PSMangelsdorf/Bolt_Invt/V0.1/ReadMe

First Pass at replacement logic board via Claude
