PSMangelsdorf/Bolt_Invt/V0.1/fab/README.md

# Bolt logic board v0.1: prototype fabrication files

**Prototype for bench testing. Do not install in a vehicle.** See *Open items* below.

Generated by `hardware/bolt_logic/tools/gen_fab.py` from `bolt_logic.kicad_pcb`; don't edit by hand.

| File | What it is |
|----|----|
| `bolt_logic_v0.1_gerbers.zip` | Gerbers (F.Cu, In1.Cu, In2.Cu, B.Cu, masks, paste, silk, outline) and Excellon drill files (plated and non-plated separate). Upload this as the PCB. |
| `bolt_logic_v0.1_bom_jlc.csv` | JLCPCB assembly BOM (61 lines), LCSC part numbers. |
| `bolt_logic_v0.1_cpl_jlc.csv` | JLCPCB placement file (220 parts, side: Top). |
| `bolt_logic_v0.1_bom_full.csv` | Every part: chosen spec, MPN, where the LCSC number was checked, and who fits it. |

## PCB order settings

| Setting | Value |
|----|----|
| Layers | 4 |
| Size | 289.1 x 112.1 mm (outline in the Gerbers) |
| Thickness | 2.0 mm |
| Material | FR-4 |
| Outer copper | **2 oz** (not the default; owner decision, for the 5 V buck's heat) |
| Inner copper | 1 oz |
| Stackup | the fab's standard 4-layer 2.0 mm stackup for this copper weight; no impedance control needed |
| Min track / gap | 0.20 mm / 0.20 mm (every copper gap passes DRC at 0.20 mm) |
| Min hole | 0.30 mm; vias 0.6 / 0.3 mm pad / drill |
| Surface finish | your choice. ENIG is flatter for the 0.5 mm pitch MCU; HASL is cheaper. |
| Remove order number | optional: there is no reserved spot for it on the silkscreen |

JLCPCB's 4-layer 2 oz limits (0.15 / 0.15 mm track and gap, 0.254 mm annular ring on
component holes) are met. A fab that needs 10 / 10 mil at 2 oz would not accept this
board; see `docs/04-layout.md` §1.

## Assembly

- Assemble the **top side** only, from the BOM and CPL above.
- Positions and rotations are KiCad's footprint origins and orientations, in the same
  frame as the Gerbers. JLCPCB's preview sometimes shows a part rotated by 90° or 180°
  against its library model (SOT-23, SOIC and LQFP most often), or offset where the
  footprint origin isn't the body centre (TO-252, TO-263, the ESP32 module). Check every
  IC's pin-1 marker and those bodies in the placement preview before confirming, or ask
  their DFM review to.
- Check stock for each line when you upload; JLCPCB shows it, and these numbers were
  checked in October 2026.

Fit by hand after delivery (or order through JLCPCB Global Sourcing, where noted):

| Ref | Part | Note |
|----|----|----|
| CN1 | GM 48-way header (part not yet identified) | hand-solder (owner); 1.0 mm placeholder holes |
| CN2 | SSW-120-01-T-D-LL (Samtec) | hand-solder (owner) |
| J1 | 1x05 2.54 mm header | hand-solder |
| J4 | 1x06 2.54 mm header | hand-solder |

## Open items before trusting this board

1. **TCA0372 pinout (U13, resolver exciter).** The symbol uses VCC = 1, OUTB = 2,
   GND = 4 / 5 / 12 / 13, -INB = 7, +INB = 8, +INA = 9, -INA = 10, OUTA = 16, NC = 3 / 6 / 11
   / 14 / 15. Two sources agree on this: the label order of the datasheet's DW pin drawing,
   and a component-library pin table. The drawing itself is a figure, so glance at it in
   onsemi's datasheet before ordering.
2. **BTS133TC (U20-U22).** C2681318 comes from the V6 BOM and isn't found at LCSC. If
   JLCPCB can't place it, fit it by hand.
3. **L30, the ESP32 supply inductor.** It is a 10 uH 0805, as on V6 (which used a 0603).
   No 0805 10 uH part is really rated for the ESP32's ~0.5 A transmit peaks. Watch for WiFi
   brown-outs on the bench.
4. **CN1 holes** are 1.0 mm placeholders; the GM header part isn't identified yet.
5. **CN2 pin 18** is assumed to be the DC-bus voltage (bench test before high voltage).
