PSMangelsdorf/Bolt_Invt/V0.1/docs/layout_placement.png

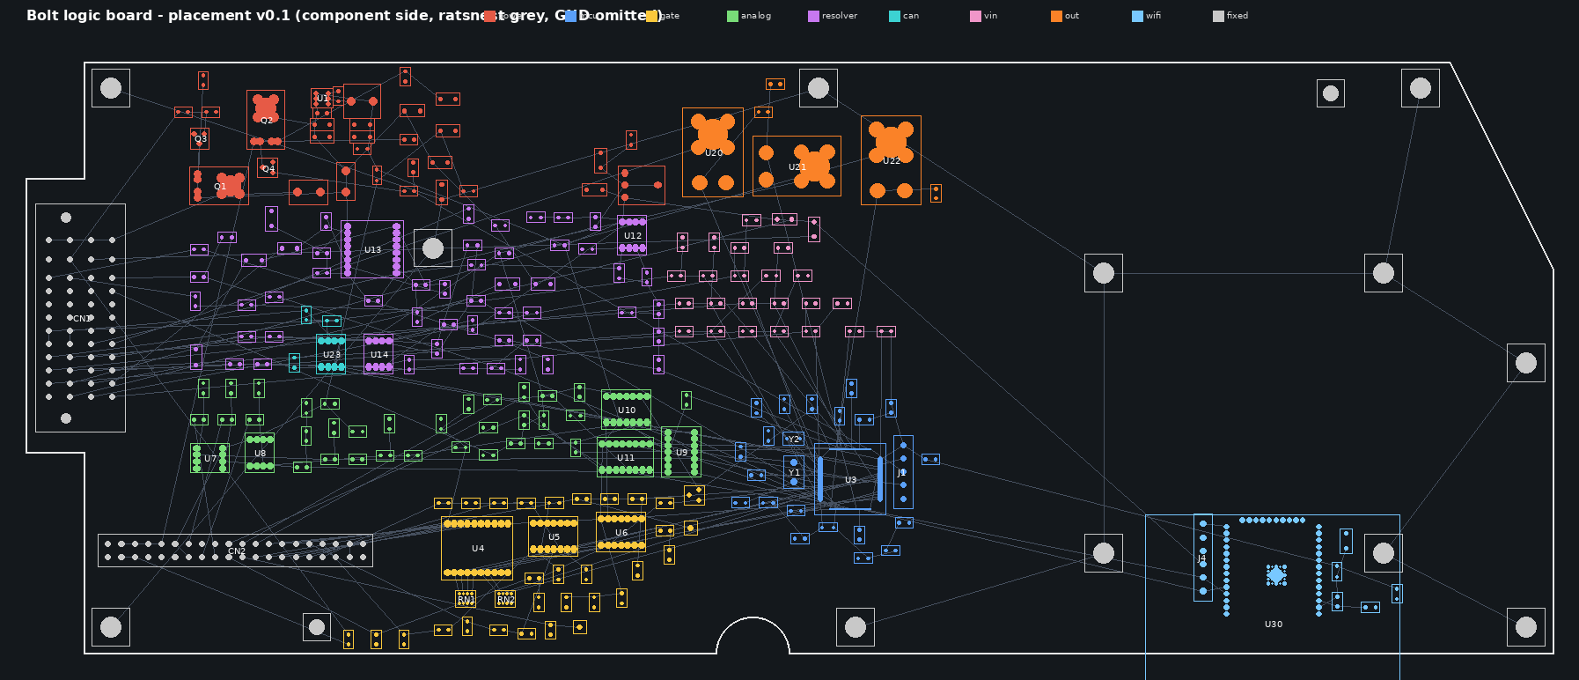
V0.1/docs/layout_placement.png
