PSMangelsdorf/Bolt_Invt/V0.1/docs/layout_routed.png

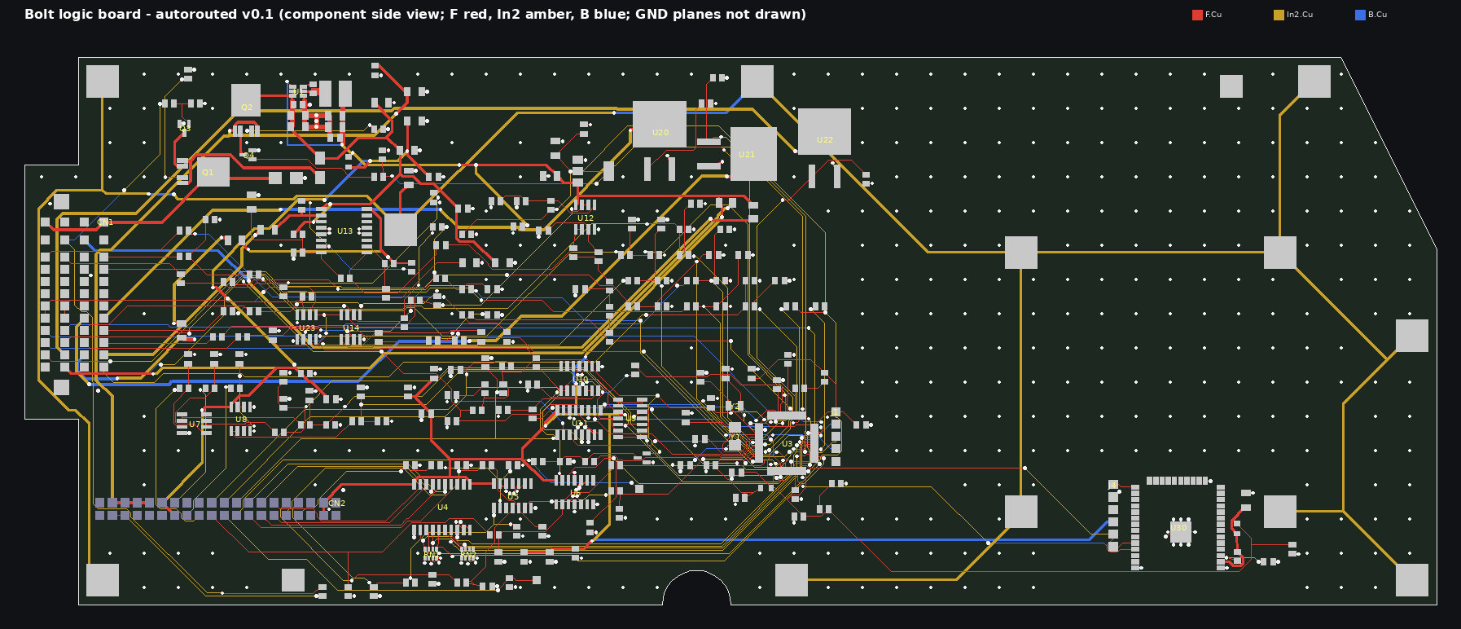
V0.1/docs/layout_routed.png
