PSMangelsdorf/Bolt_Invt/V0.1/docs/mechanical_overlay.png

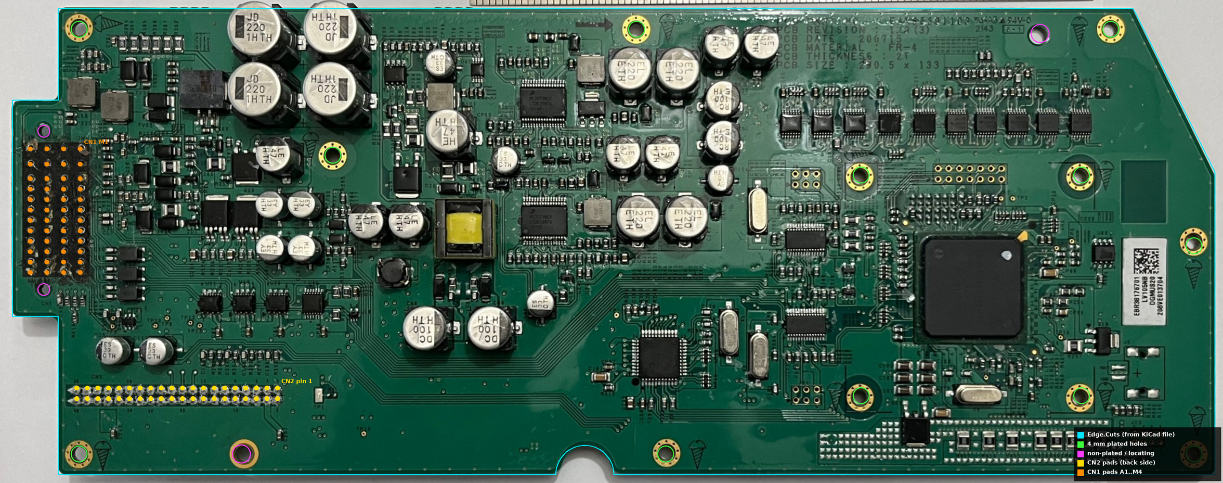
V0.1/docs/mechanical_overlay.png
