PSMangelsdorf/Bolt_Invt/V0.1/fab/bolt_logic_v0.1_bom_full.csv

Qty | Designators | Value | Footprint | Chosen spec | MPN | LCSC | Source | Fit by | Note
4 | C1,C2,C3,C4 | 10uF 50V | C_1206_3216Metric | 10 uF X5R 50 V | CL31A106KBHNNNE | C13585 | lcsc | smt
27 | C5,C6,C9,C12,C14,C16,C20,C21,C22,C23,C26,C27,C40,C46,C47,C54,C57,C60,C61,C62,C73,C75,C79,C84,C109,C121,C122 | 100nF | C_0805_2012Metric | 100 nF X7R 50 V | CC0805KRX7R9BB104 | C49678 | lcsc | smt | same part as V6; 50 V because some sit on 12 V rails
3 | C7,C8,C11 | 22uF | C_1206_3216Metric | 22 uF X5R 25 V | CL31A226KAHNNNE | C12891 | lcsc | smt
3 | C10,C13,C120 | 10uF | C_1206_3216Metric | 10 uF X5R 25 V | CL31A106KAHNNNE | C9807 | lcsc | smt | 5 V / 3.3 V rails
5 | C15,C77,C78,C80,C81 | 10uF 25V | C_1206_3216Metric | 10 uF X5R 25 V | CL31A106KAHNNNE | C9807 | lcsc | smt
1 | C24 | 4.7uF | C_0805_2012Metric | 4.7 uF X5R 25 V | CL21A475KAQNNNE | C1779 | lcsc | smt
15 | C25,C58,C59,C63,C64,C65,C66,C76,C100,C101,C102,C103,C104,C107,C108 | 1uF | C_0805_2012Metric | 1 uF X7R 50 V | CL21B105KBFNNNE | C28323 | lcsc | smt | same part as V6
2 | C28,C29 | 22pF | C_0805_2012Metric | 22 pF C0G 50 V | 0805CG220J500NT | C24658 | lcsc | smt
2 | C30,C31 | 10pF | C_0805_2012Metric | 10 pF C0G 50 V | 0805CG100J500NT | C157608 | lcsc | smt
5 | C41,C42,C43,C44,C45 | 10nF | C_0805_2012Metric | 10 nF X7R 50 V | CL21B103KBANNNC | C1710 | lcsc | smt | same part as V6
11 | C48,C51,C53,C56,C82,C83,C85,C86,C87,C88,C89 | 1nF | C_0805_2012Metric | 1 nF X7R 50 V | CL21B102KBCNNNC | C46653 | lcsc | smt | same part as V6
4 | C50,C52,C55,C71 | 4.7nF | C_0805_2012Metric | 4.7 nF C0G 50 V (Murata) | GRM2165C1H472JA01D | C77063 | lcsc | smt | C0G proposed: exciter filter and current-sense filters
1 | C70 | 3.3nF | C_0805_2012Metric | 3.3 nF C0G 50 V (Murata) | GRM2165C1H332JA01D | C77062 | lcsc | smt | C0G proposed: exciter sine filter
1 | C72 | 2.2nF | C_0805_2012Metric | 2.2 nF C0G 50 V | 0805CG222J500NT | C51795 | lcsc | smt | C0G proposed: exciter sine filter
1 | CN1 | GM X1 48-way | CN1_GM_48pos_4x12 | vehicle connector | GM 48-way header (part not yet identified) |  |  | hand | hand-solder (owner); 1.0 mm placeholder holes
1 | CN2 | SSW-120-01-T-D-LL | CN2_2x20_P2.54_Receptacle_Back | 2x20 receptacle, bottom side | SSW-120-01-T-D-LL (Samtec) |  |  | hand | hand-solder (owner)
1 | D1 | SS54 | D_SMA | 40 V 5 A Schottky (MDD) | SS54 | C22452 | lcsc | smt | same part as V6
1 | D2 | BAT54S | SOT-23 | dual Schottky, series (Nexperia) | BAT54S,215 | C47546 | lcsc | smt
1 | F1 | 50mA | Fuse_1206_3216Metric | PPTC 50 mA hold, 60 V (Littelfuse) | 1206L005/60WR | C315892 | lcsc | smt
1 | F2 | 200mA | Fuse_1206_3216Metric | PPTC 200 mA hold, 24 V (Littelfuse) | 1206L020YR | C207035 | lcsc | smt
1 | FB1 | 600R@100MHz 1A | L_0805_2012Metric | 600 ohm @ 100 MHz, 500 mA, 0.3 ohm | GZ2012D601TF | C1017 | lcsc | smt | rated 500 mA, not the 1 A in the value field; the +5V_A load (gate-board current sensors) is well under that
1 | J1 | SWD | PinHeader_1x05_P2.54mm_Vertical | SWD | 1x05 2.54 mm header |  |  | hand | hand-solder
1 | J4 | ESP PROG | PinHeader_1x06_P2.54mm_Vertical | ESP32 programming | 1x06 2.54 mm header |  |  | hand | hand-solder
1 | L1 | 6.8uH | L_Bourns_SRN6045TA | 6.8 uH 20% (Bourns) | SRN6045TA-6R8M | C2041457 | lcsc | smt
2 | L2,L30 | 10uH | L_0805_2012Metric | 10 uH 0805, DCR 0.3 ohm (TDK) | MLZ2012N100LT000 | C88182 | lcsc | smt | L30 feeds the ESP32 (~0.5 A transmit peaks): no 0805 10 uH part is really rated for that. V6 used a 0603 10 uH (C1035) here. Review
1 | LED1 | PWR green | LED_0805_2012Metric | green 0805 | KT-0805G | C2297 | lcsc | smt
1 | LED2 | STATUS | LED_0805_2012Metric | green 0805 | KT-0805G | C2297 | lcsc | smt | colour not specified; green proposed
2 | Q1,Q2 | BTS6143D | TO-252-4 | PROFET high-side 10 mohm, PG-TO252-5-11 (Infineon) | BTS6143D | C95232 | lcsc | smt | owner: replaces BTS443P (same pinout and IN-to-GND input)
2 | Q3,Q4 | 2N7002 | SOT-23 | 60 V N-MOSFET (JSCJ) | 2N7002 | C8545 | lcsc | smt | new in v0.1: BTS443P input switch
36 | R1,R5,R10,R14,R31,R35,R37,R49,R50,R51,R61,R62,R63,R64,R65,R67,R68,R71,R72,R73,R76,R77,R80,R81,R88,R90,R92,R111,R113,R114,R115,R116,R117,R120,R121,R122 | 10k | R_0805_2012Metric | 10 k 1% | 0805W8F1002T5E | C17414 | lcsc | smt
1 | R2 | 6.8k | R_0805_2012Metric | 6.8 k 1% | 0805W8F6801T5E | C17772 | lcsc | smt
8 | R3,R4,R6,R13,R33,R40,R43,R46 | 1k | R_0805_2012Metric | 1 k 1% | 0805W8F1001T5E | C17513 | lcsc | smt
1 | R7 | 0R | R_1206_3216Metric | 0 ohm jumper 1206 | 1206W4F0000T5E | C17888 | lcsc | smt
17 | R11,R42,R45,R48,R52,R53,R54,R78,R79,R82,R83,R100,R102,R104,R106,R108,R130 | 4.7k | R_0805_2012Metric | 4.7 k 1% | 0805W8F4701T5E | C17673 | lcsc | smt
1 | R12 | 470 | R_0805_2012Metric | 470 ohm 1% | 0805W8F4700T5E | C17710 | lcsc | smt
1 | R20 | 124k | R_0805_2012Metric | 124 k 1% (Vishay) | CRCW0805124KFKEA | C4135024 | lcsc | smt | only 124 k 0805 found; check stock
6 | R21,R23,R25,R27,R29,R69 | 100k | R_0805_2012Metric | 100 k 1% | 0805W8F1003T5E | C149504 | lcsc | smt
5 | R22,R24,R26,R28,R30 | 560 | R_0805_2012Metric | 560 ohm 1% | 0805W8F5600T5E | C28636 | lcsc | smt
2 | R32,R70 | 20k | R_0805_2012Metric | 20 k 1% | 0805W8F2002T5E | C4328 | lcsc | smt
1 | R34 | 33k | R_0805_2012Metric | 33 k 1% | 0805W8F3302T5E | C17633 | lcsc | smt
1 | R36 | 3.3k | R_0805_2012Metric | 3.3 k 1% | 0805W8F3301T5E | C26010 | lcsc | smt
3 | R41,R44,R47 | 2.7k | R_0805_2012Metric | 2.7 k 1% | 0805W8F2701T5E | C17530 | lcsc | smt
1 | R55 | 2.2k | R_0805_2012Metric | 2.2 k 1% | 0805W8F2201T5E | C17520 | lcsc | smt
4 | R60,R85,R87,R124 | 0R | R_0805_2012Metric | 0 ohm jumper | 0805W8F0000T5E | C17477 | lcsc | smt
2 | R74,R75 | 10 | R_1206_3216Metric | 10 ohm 5% 1206 | 1206W4F100JT5E | C17903 | lcsc | smt
2 | R84,R86 | 100 | R_0805_2012Metric | 100 ohm 1% | 0805W8F1000T5E | C17408 | lcsc | smt
3 | R89,R91,R93 | 0R (DNP) | R_0805_2012Metric | not fitted |  |  |  | none | DNP
5 | R101,R103,R105,R107,R109 | 1.5k | R_0805_2012Metric | 1.5 k 1% | 0805W8F1501T5E | C4310 | lcsc | smt
1 | R123 | 120 | R_0805_2012Metric | 120 ohm 1% (CAN termination) | 0805W8F1200T5E | C17437 | lcsc | smt
2 | RN1,RN2 | 4x10k | R_Array_Convex_4x0603 | 4 x 10 k convex array | 4D03WGJ0103T5E | C29718 | lcsc | smt | same part as V6
1 | TP1 | GB_AUX | TestPoint_Pad_D1.5mm | test pad |  |  |  | none
1 | TP2 | GB_UDC | TestPoint_Pad_D1.5mm | test pad |  |  |  | none
1 | TVS1 | SMBJ26CA | D_SMB | 26 V bidirectional TVS, 600 W (Littelfuse) | SMBJ26CA | C83332 | lcsc | smt | owner: Littelfuse instead of Bourns C3719606 (out of stock at JLCPCB)
1 | U1 | AP63205WU | TSOT-23-6 | 5 V 2 A sync buck (Diodes) | AP63205WU-7 | C2071056 | lcsc | smt
1 | U2 | LD1117S33TR | SOT-223-3_TabPin2 | 3.3 V LDO (ST) | LD1117S33TR | C86781 | lcsc | smt
1 | U3 | STM32F103RBT6 | LQFP-64_10x10mm_P0.5mm | MCU | STM32F103RBT6 | C8735 | lcsc | smt | same part as V6
1 | U4 | 74HCT573 | SOIC-20W_7.5x12.8mm_P1.27mm | octal latch (Nexperia) | 74HCT573D,653 | C5209384 | lcsc | smt | V6 BOM lists C5608, which LCSC shows as the HC part
1 | U5 | 74HC21 | SOIC-14_3.9x8.7mm_P1.27mm | dual 4-input AND (Nexperia) | 74HC21D,653 | C5617 | lcsc | smt
1 | U6 | SN74ACT10 | SOIC-14_3.9x8.7mm_P1.27mm | triple 3-input NAND, ACT (TI) | SN74ACT10DR | C2861739 | lcsc | smt | owner: replaces 74HCT10D C547236 (out of stock); TTL-level inputs like HCT; low stock (89 at LCSC, Oct 2026)
4 | U7,U8,U12,U14 | MCP6292 | SOIC-8_3.9x4.9mm_P1.27mm | dual RRIO op-amp (Microchip) | MCP6292-E/SN | C556929 | lcsc | smt | low stock at LCSC (38 in October 2026; 4 per board)
2 | U9,U10 | LM2901 | SOIC-14_3.9x8.7mm_P1.27mm | quad comparator (TI) | LM2901DR | C7932 | lcsc | smt
1 | U11 | 74HCT4052 | SOIC-16_3.9x9.9mm_P1.27mm | dual 4:1 analog mux, HCT (TI) | CD74HCT4052M96 | C469908 | lcsc | smt
1 | U13 | TCA0372DW | SOIC-16W_7.5x10.3mm_P1.27mm | dual 1 A power op-amp (onsemi) | TCA0372DWR2G | C362060 | lcsc | smt | owner: replaces L272D (not stocked)
3 | U20,U21,U22 | BTS133TC | TO-263-2 | HITFET low-side, TO-263 | BTS133TC (BTS133TCBUMA1) | C2681318 | v6 | smt | owner: keep. Number from the V6 BOM, not found at LCSC: if JLCPCB can't place it, hand-solder (Digi-Key / Farnell / RS)
1 | U23 | SN65HVD234 | SOIC-8_3.9x4.9mm_P1.27mm | 3.3 V CAN transceiver (TI) | SN65HVD234DR | C99818 | lcsc | smt
1 | U30 | ESP32-WROOM-32E | ESP32-WROOM-32 | WiFi module, PCB antenna | ESP32-WROOM-32E-N4 | C701341 | lcsc | smt
1 | Y1 | 8MHz | Crystal_SMD_5032-2Pin_5.0x3.2mm | 8 MHz 5032 (YXC) | X50328MSB2GI | C115962 | lcsc | smt | same part as V6
1 | Y2 | 32.768kHz | Crystal_SMD_3215-2Pin_3.2x1.5mm | 32.768 kHz, 12.5 pF (Epson) | Q13FC13500004 | C32346 | lcsc | smt | 12.5 pF crystal with the board's 10 pF caps runs a little fast (RTC only); no 7 pF version found at LCSC
