PSMangelsdorf/Bolt_Invt/V0.1/docs/bolt_logic_schematic.pdf

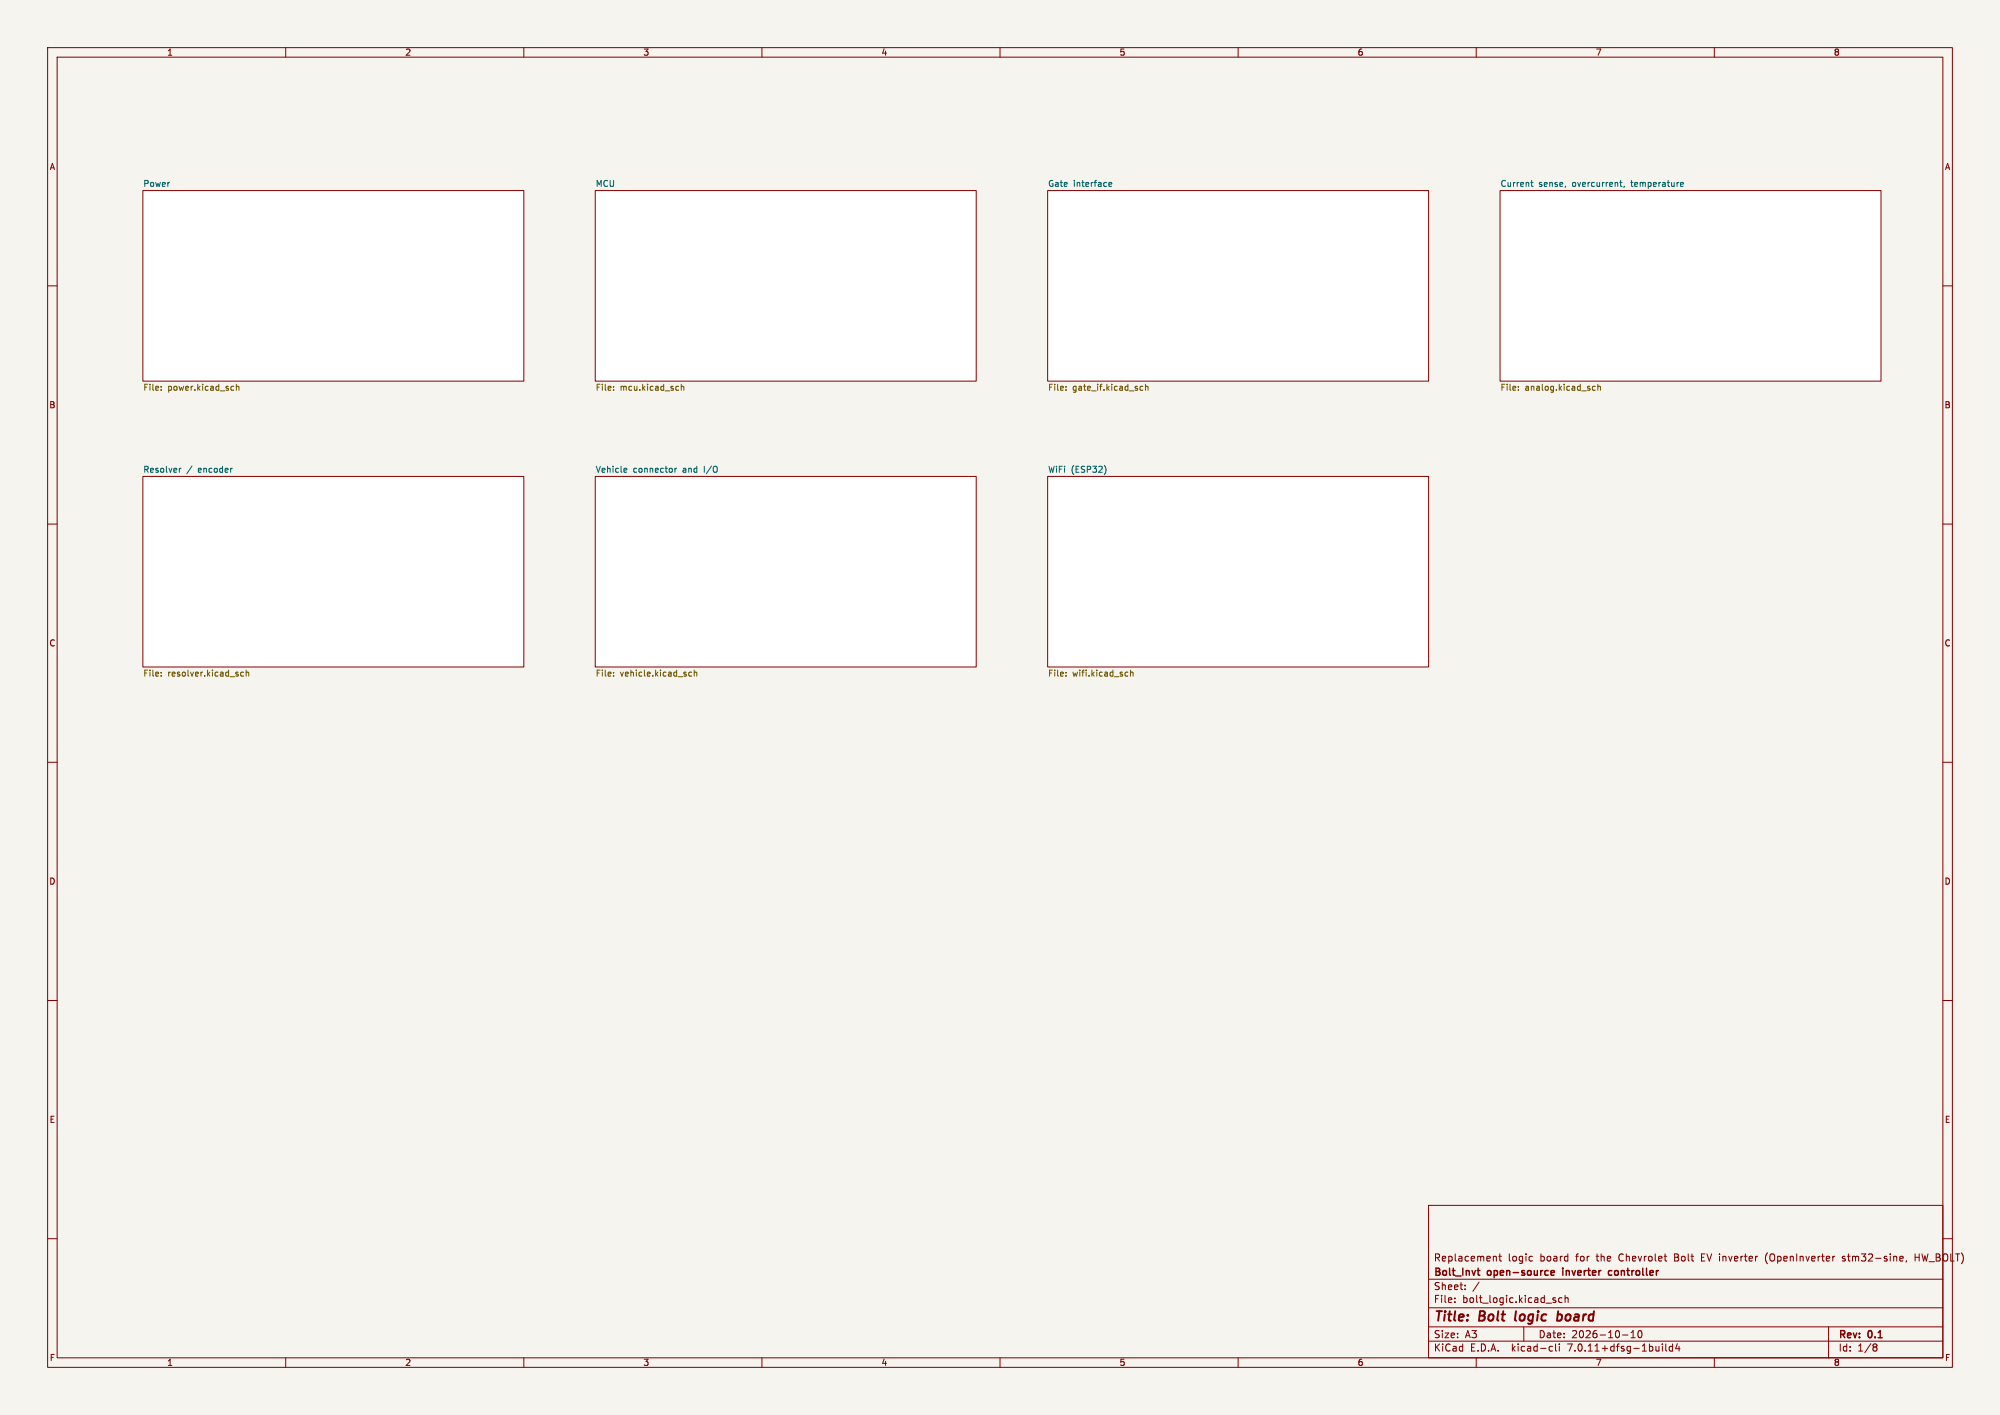
[picture p5: page 1]

Id: 1/8 Title: Bolt logic board

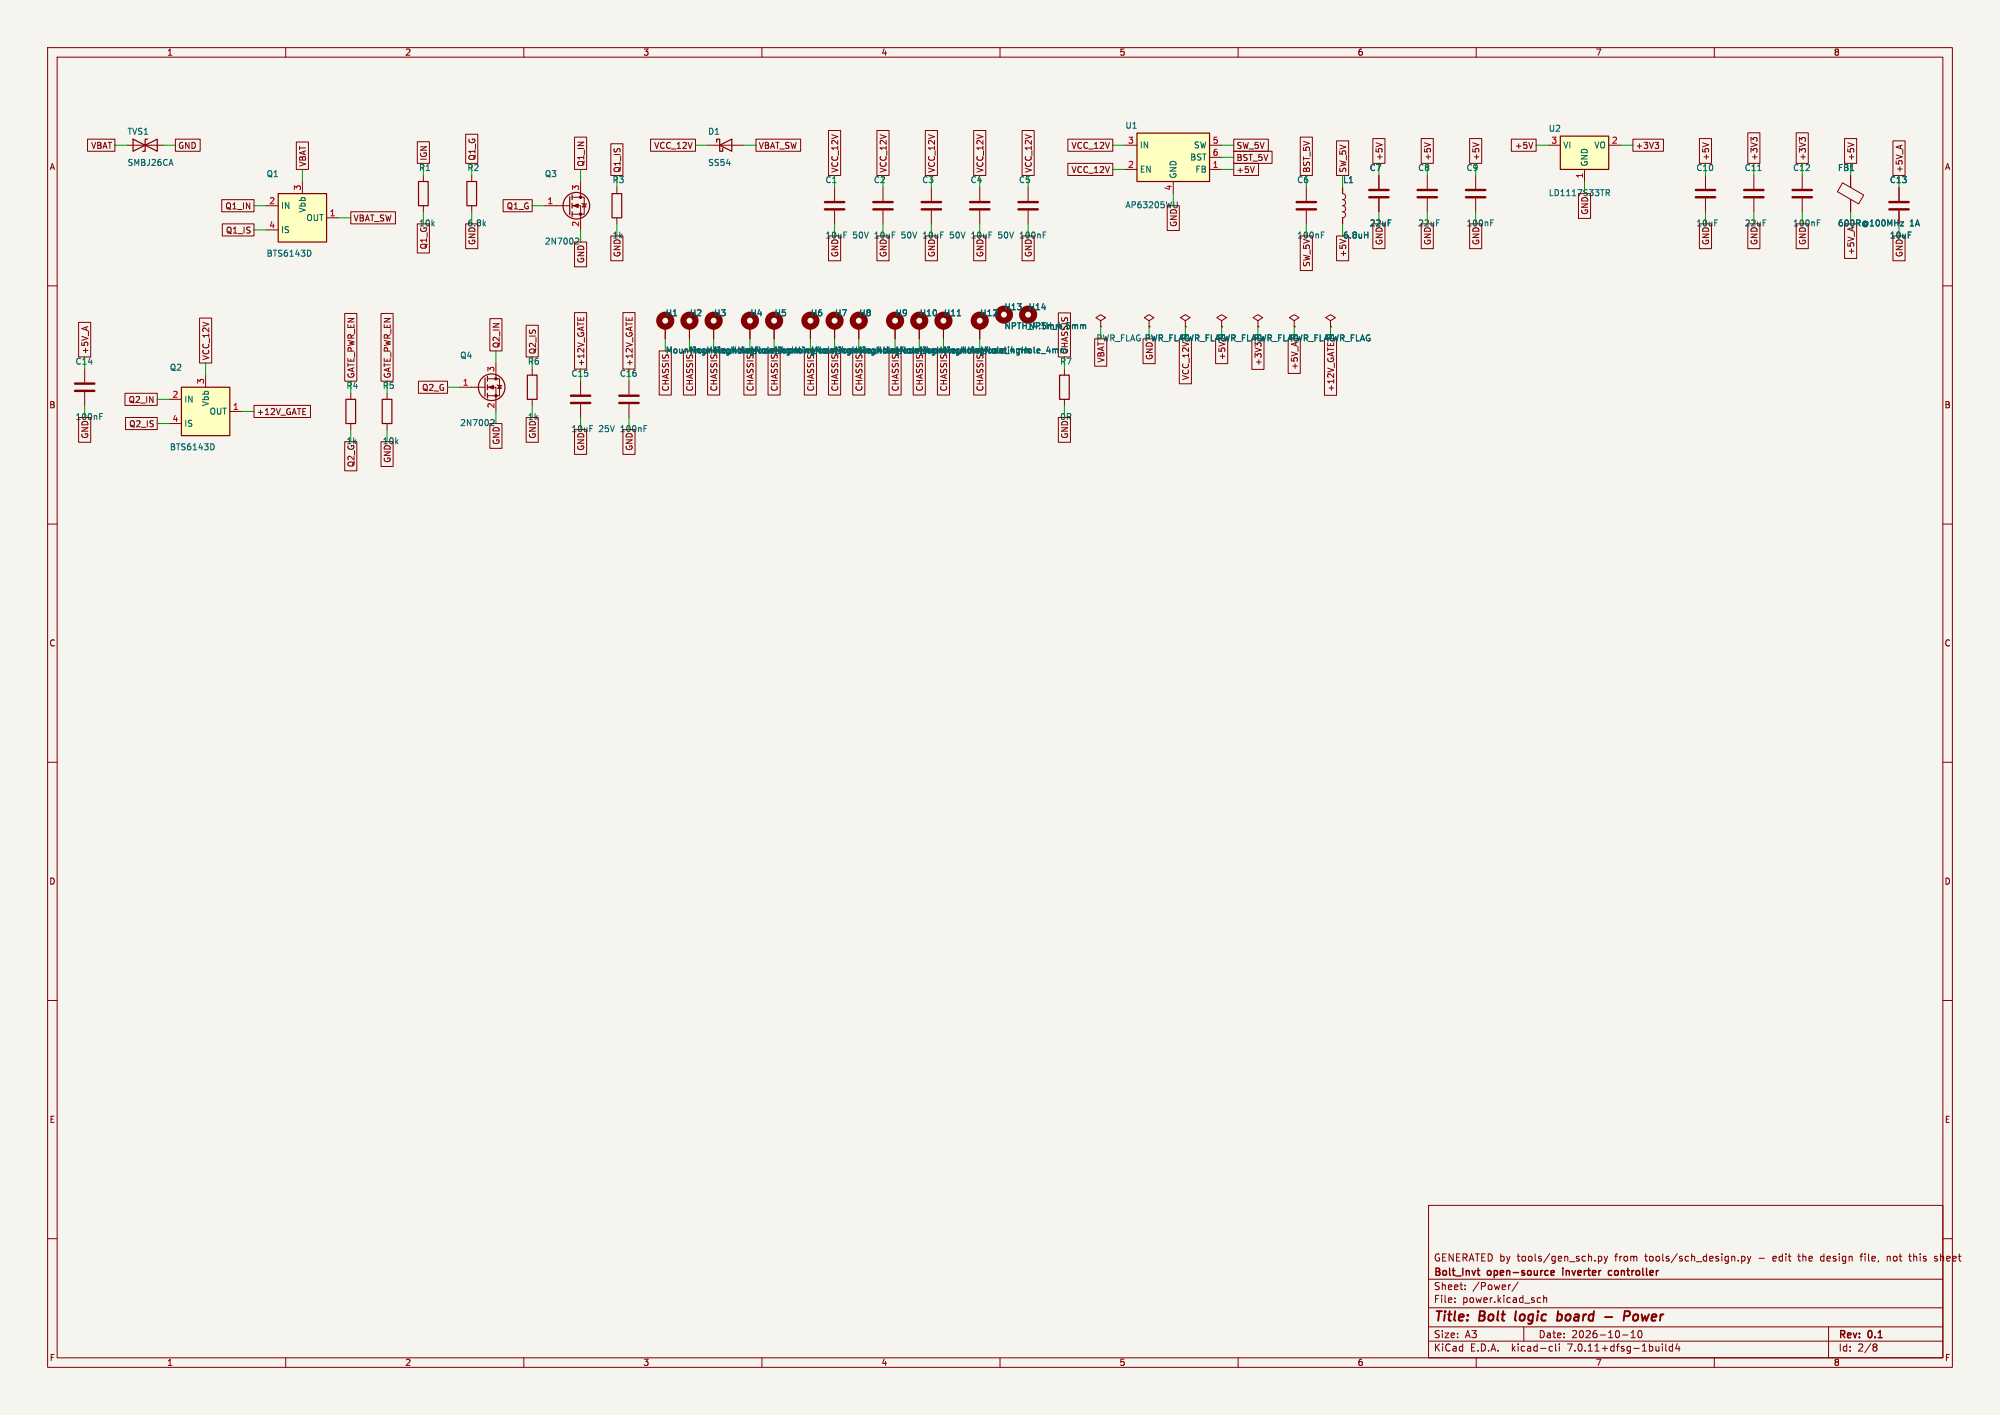
[picture p6: page 2]

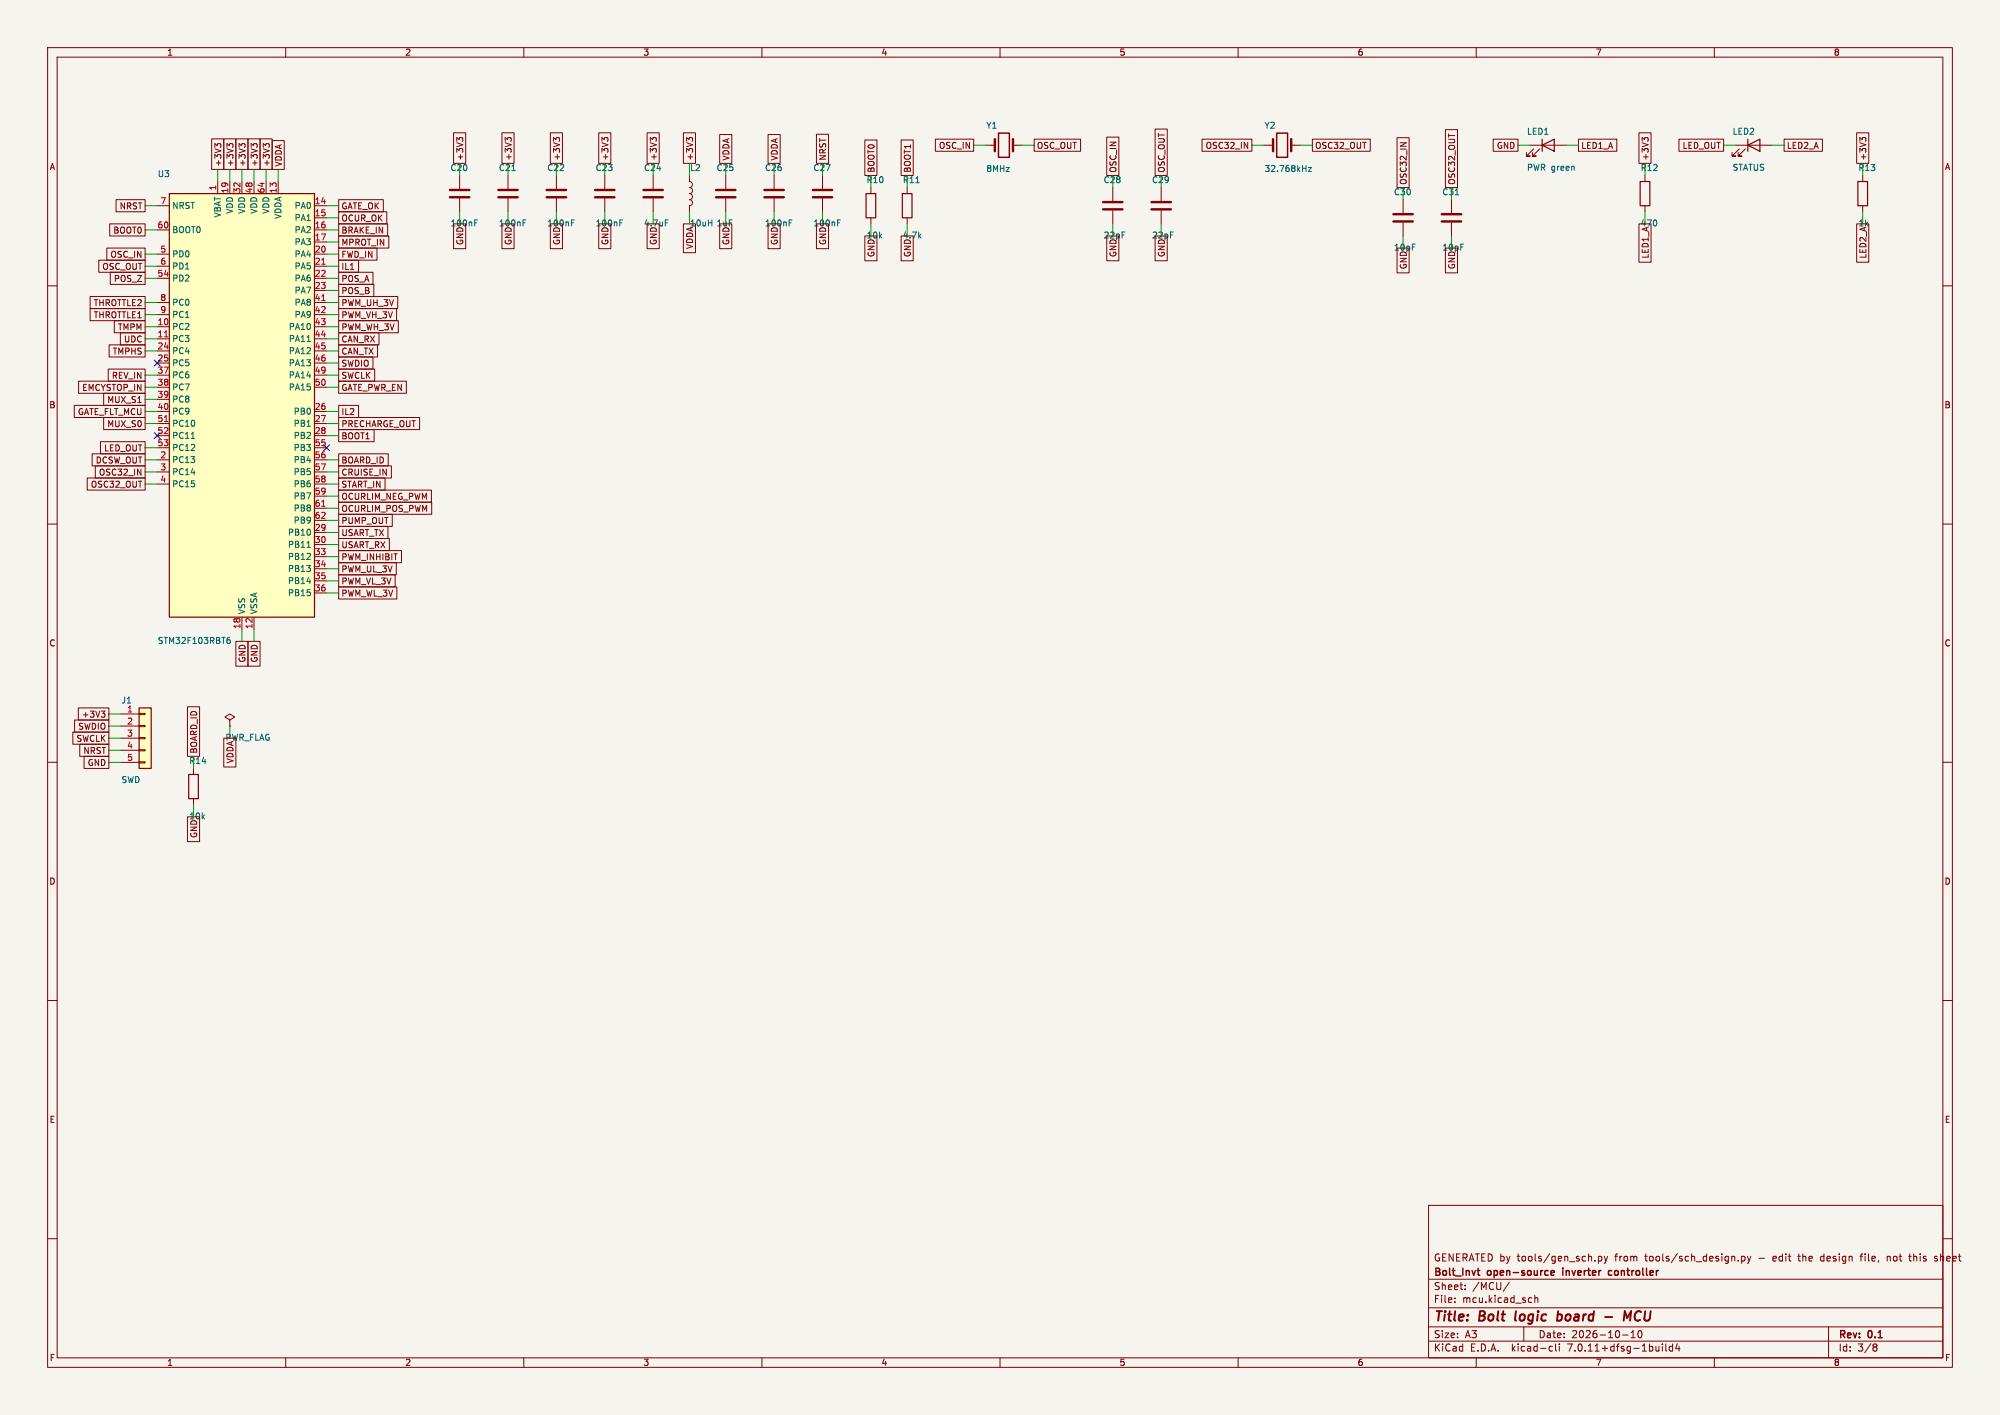
[picture p7: page 3]

1 PC2 10 PC3 11 VSSA 12 VDDA 13 PA0 14 PA1 15 PA2 16 PA3 17 VSS 18 VDD 19 PC13 2 PA4 20 PA5 21 PA6 22 PA7 23 PC4 24 PC5 25 PB0 26 PB1 27 PB2 28 PB10 29 PC14 3 PB11 30 VDD 32 PB12 33 PB13 34 PB14 35 PB15 36 PC6 37 PC7 38 PC8 39 PC15 4 PC9 40 PA8 41 PA9 42 PA10 43 PA11 44 PA12 45 PA13 46 VDD 48 PA14 49 PD0 5 PA15 50 PC10 51 PC11 52 PC12 53 PD2 54 PB3 55 PB4 56 PB5 57 PB6 58 PB7 59 PD1 6 BOOT0 60 PB8 61 PB9 62 VDD 64 NRST 7 PC0 8 PC1 9U3STM32F103RBT6

Id: 3/8 Title: Bolt logic board - MCU

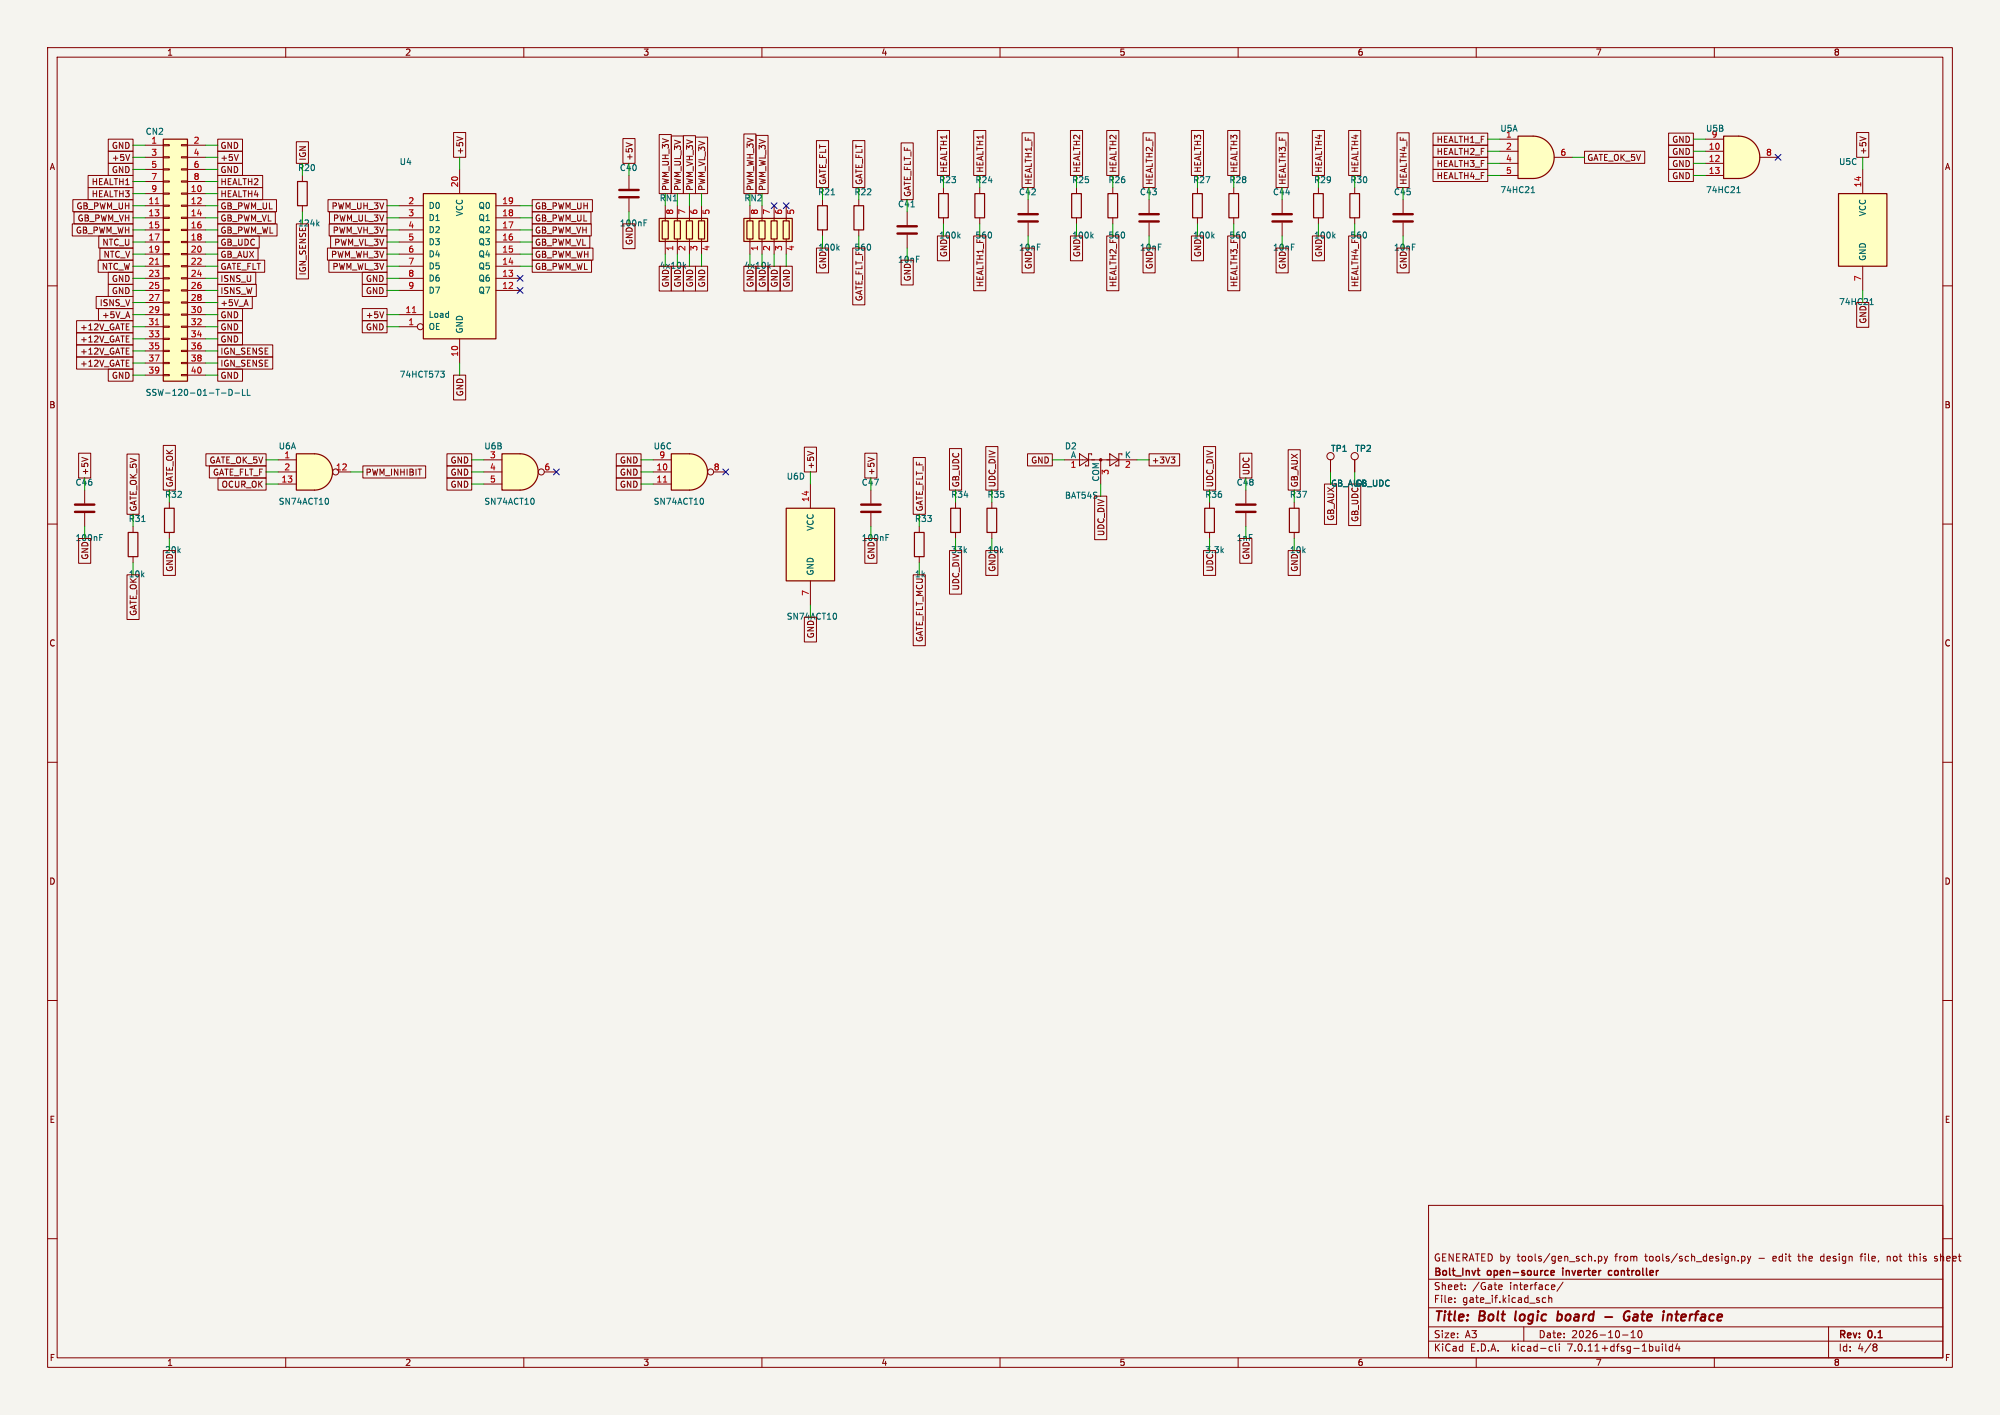
[picture p8: page 4]

Id: 4/8 Title: Bolt logic board - Gate interface

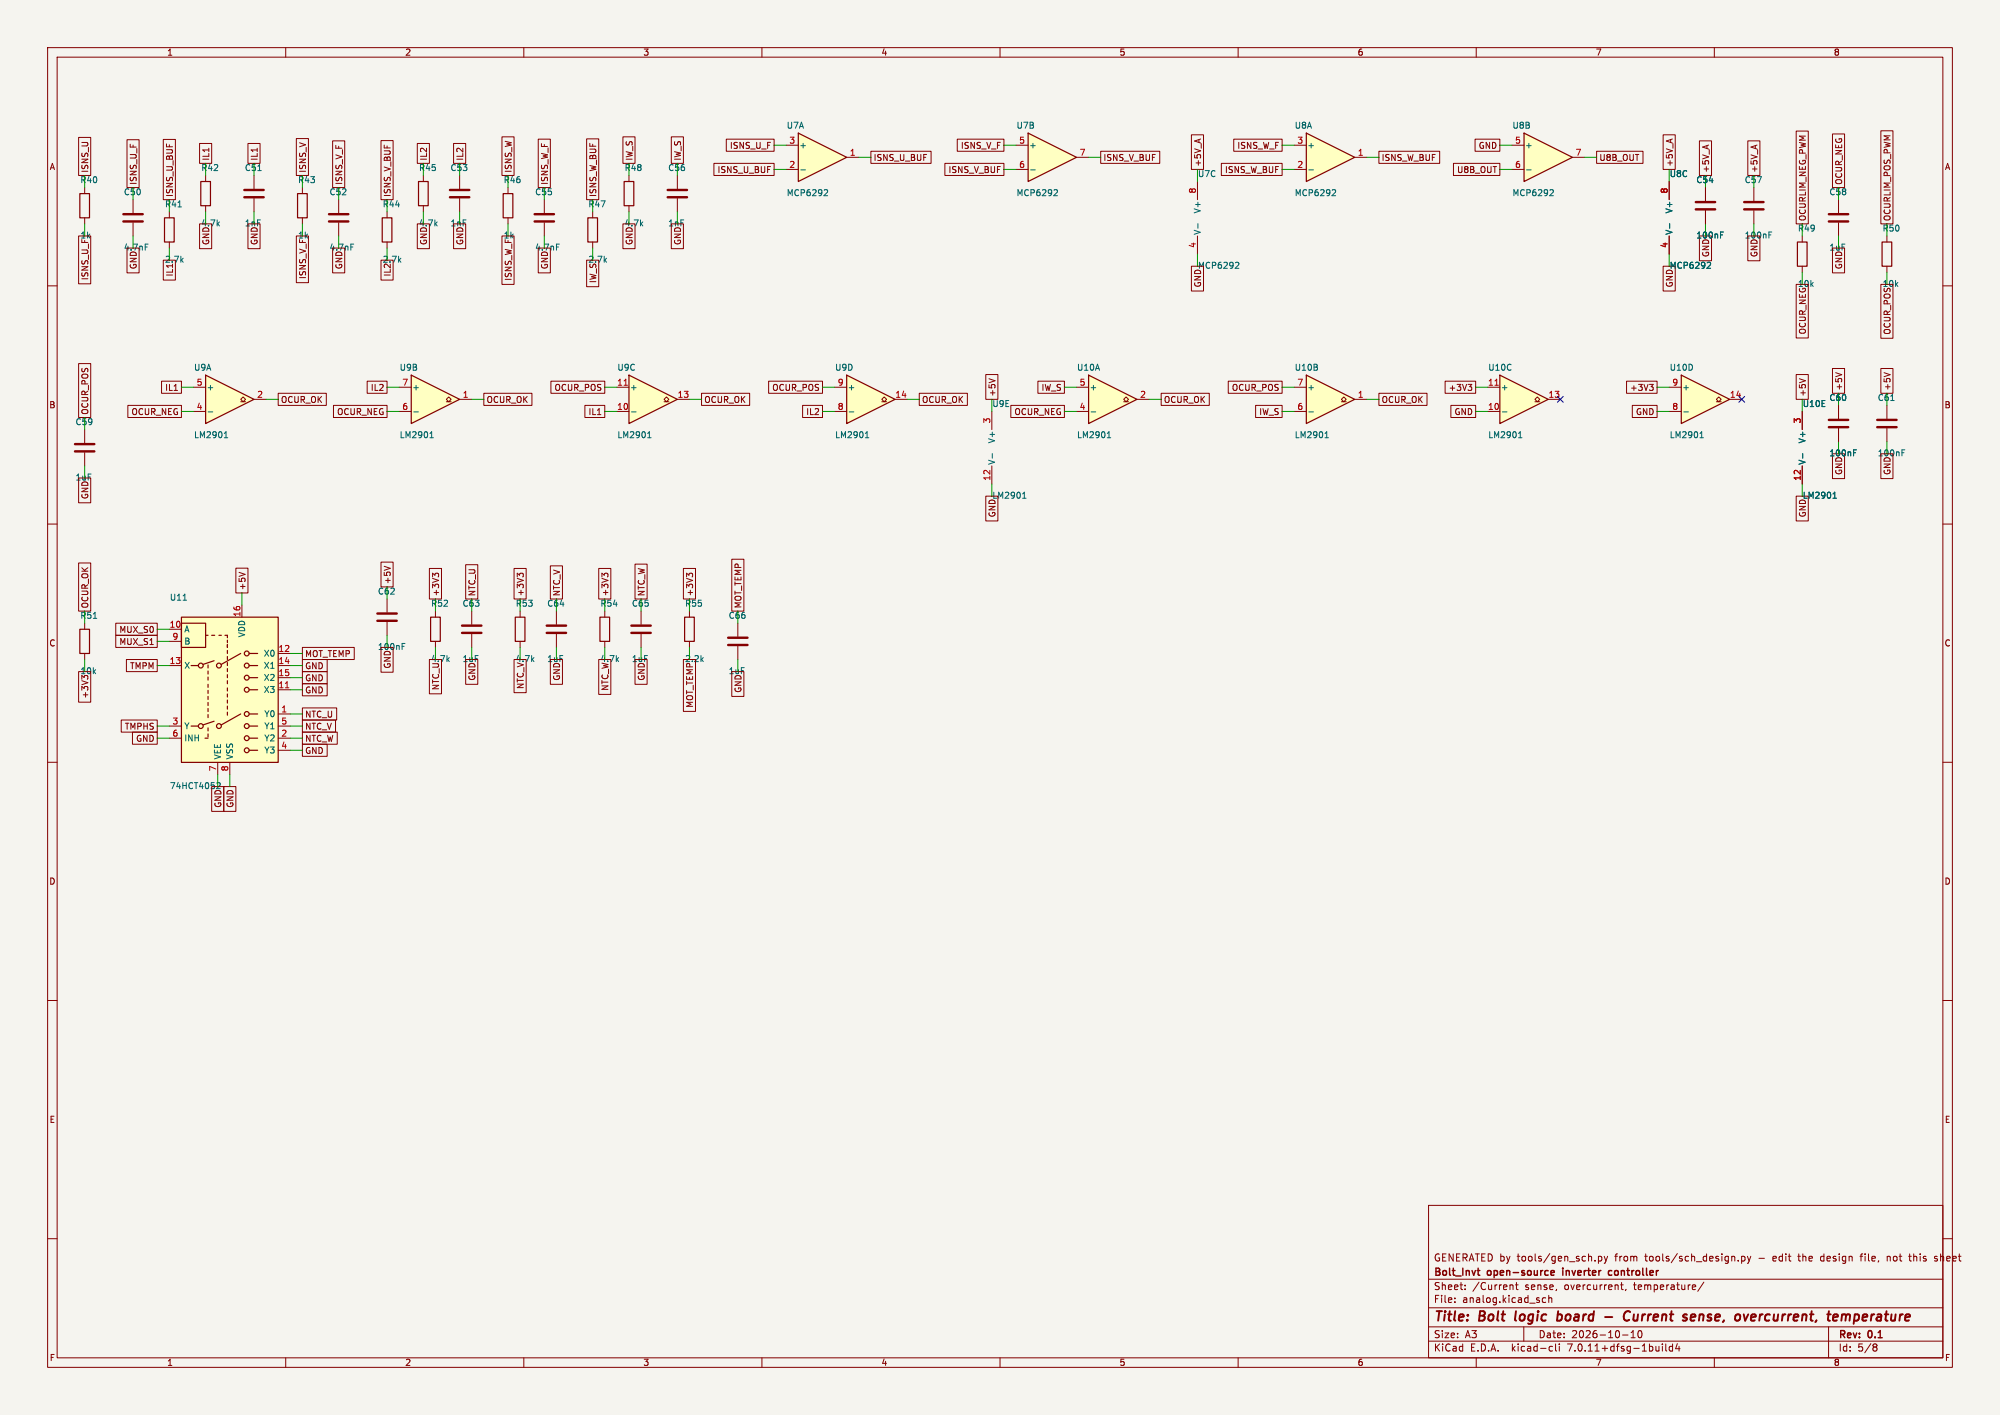
[picture p9: page 5]

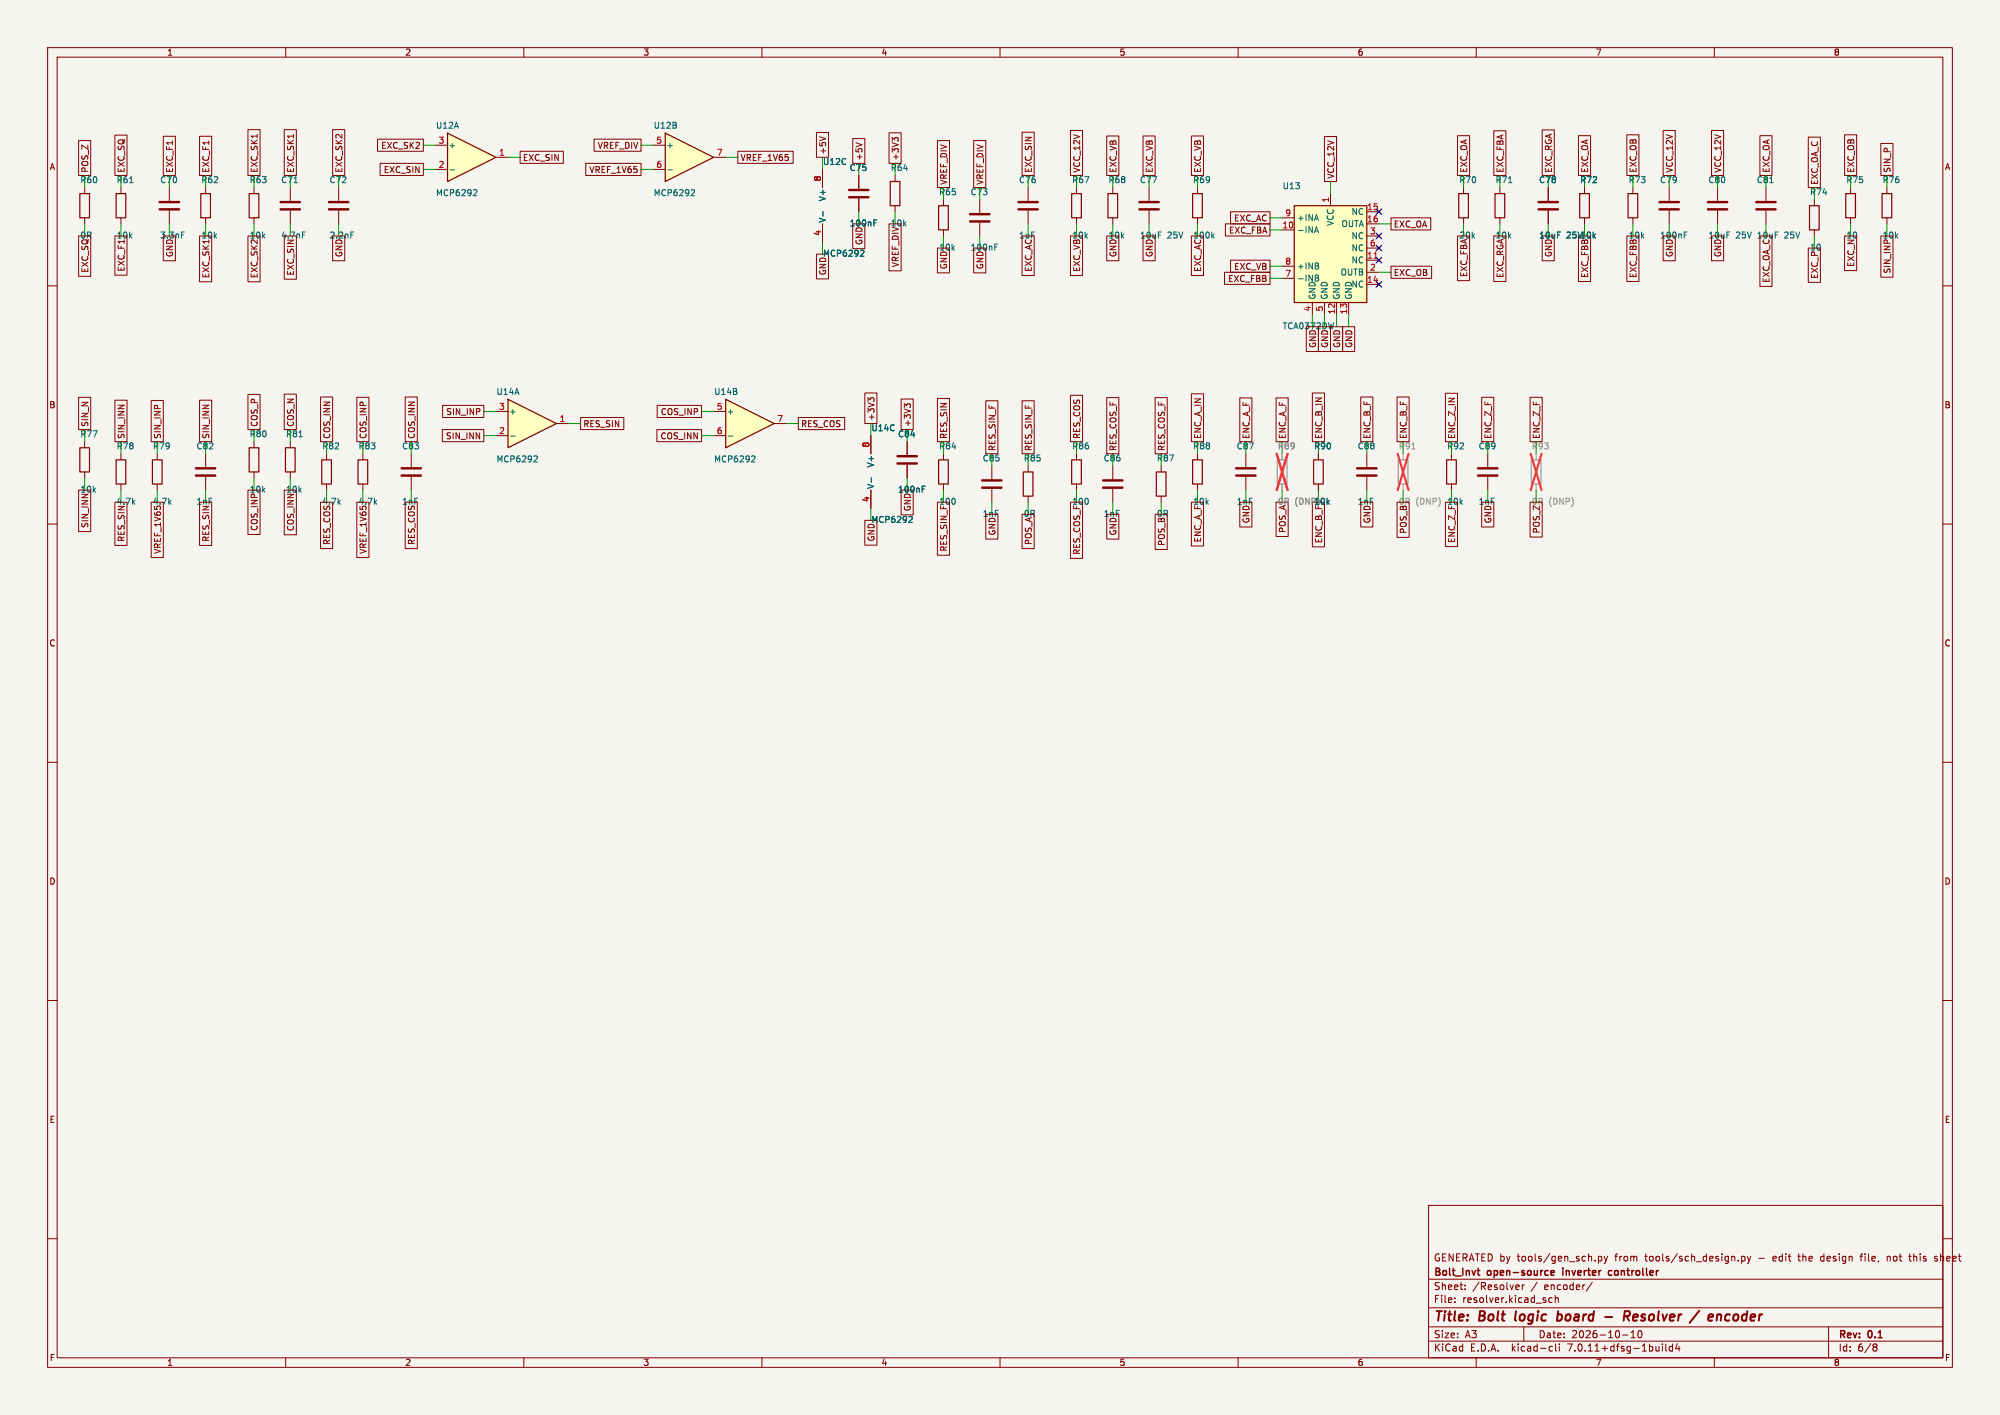
[picture p10: page 6]

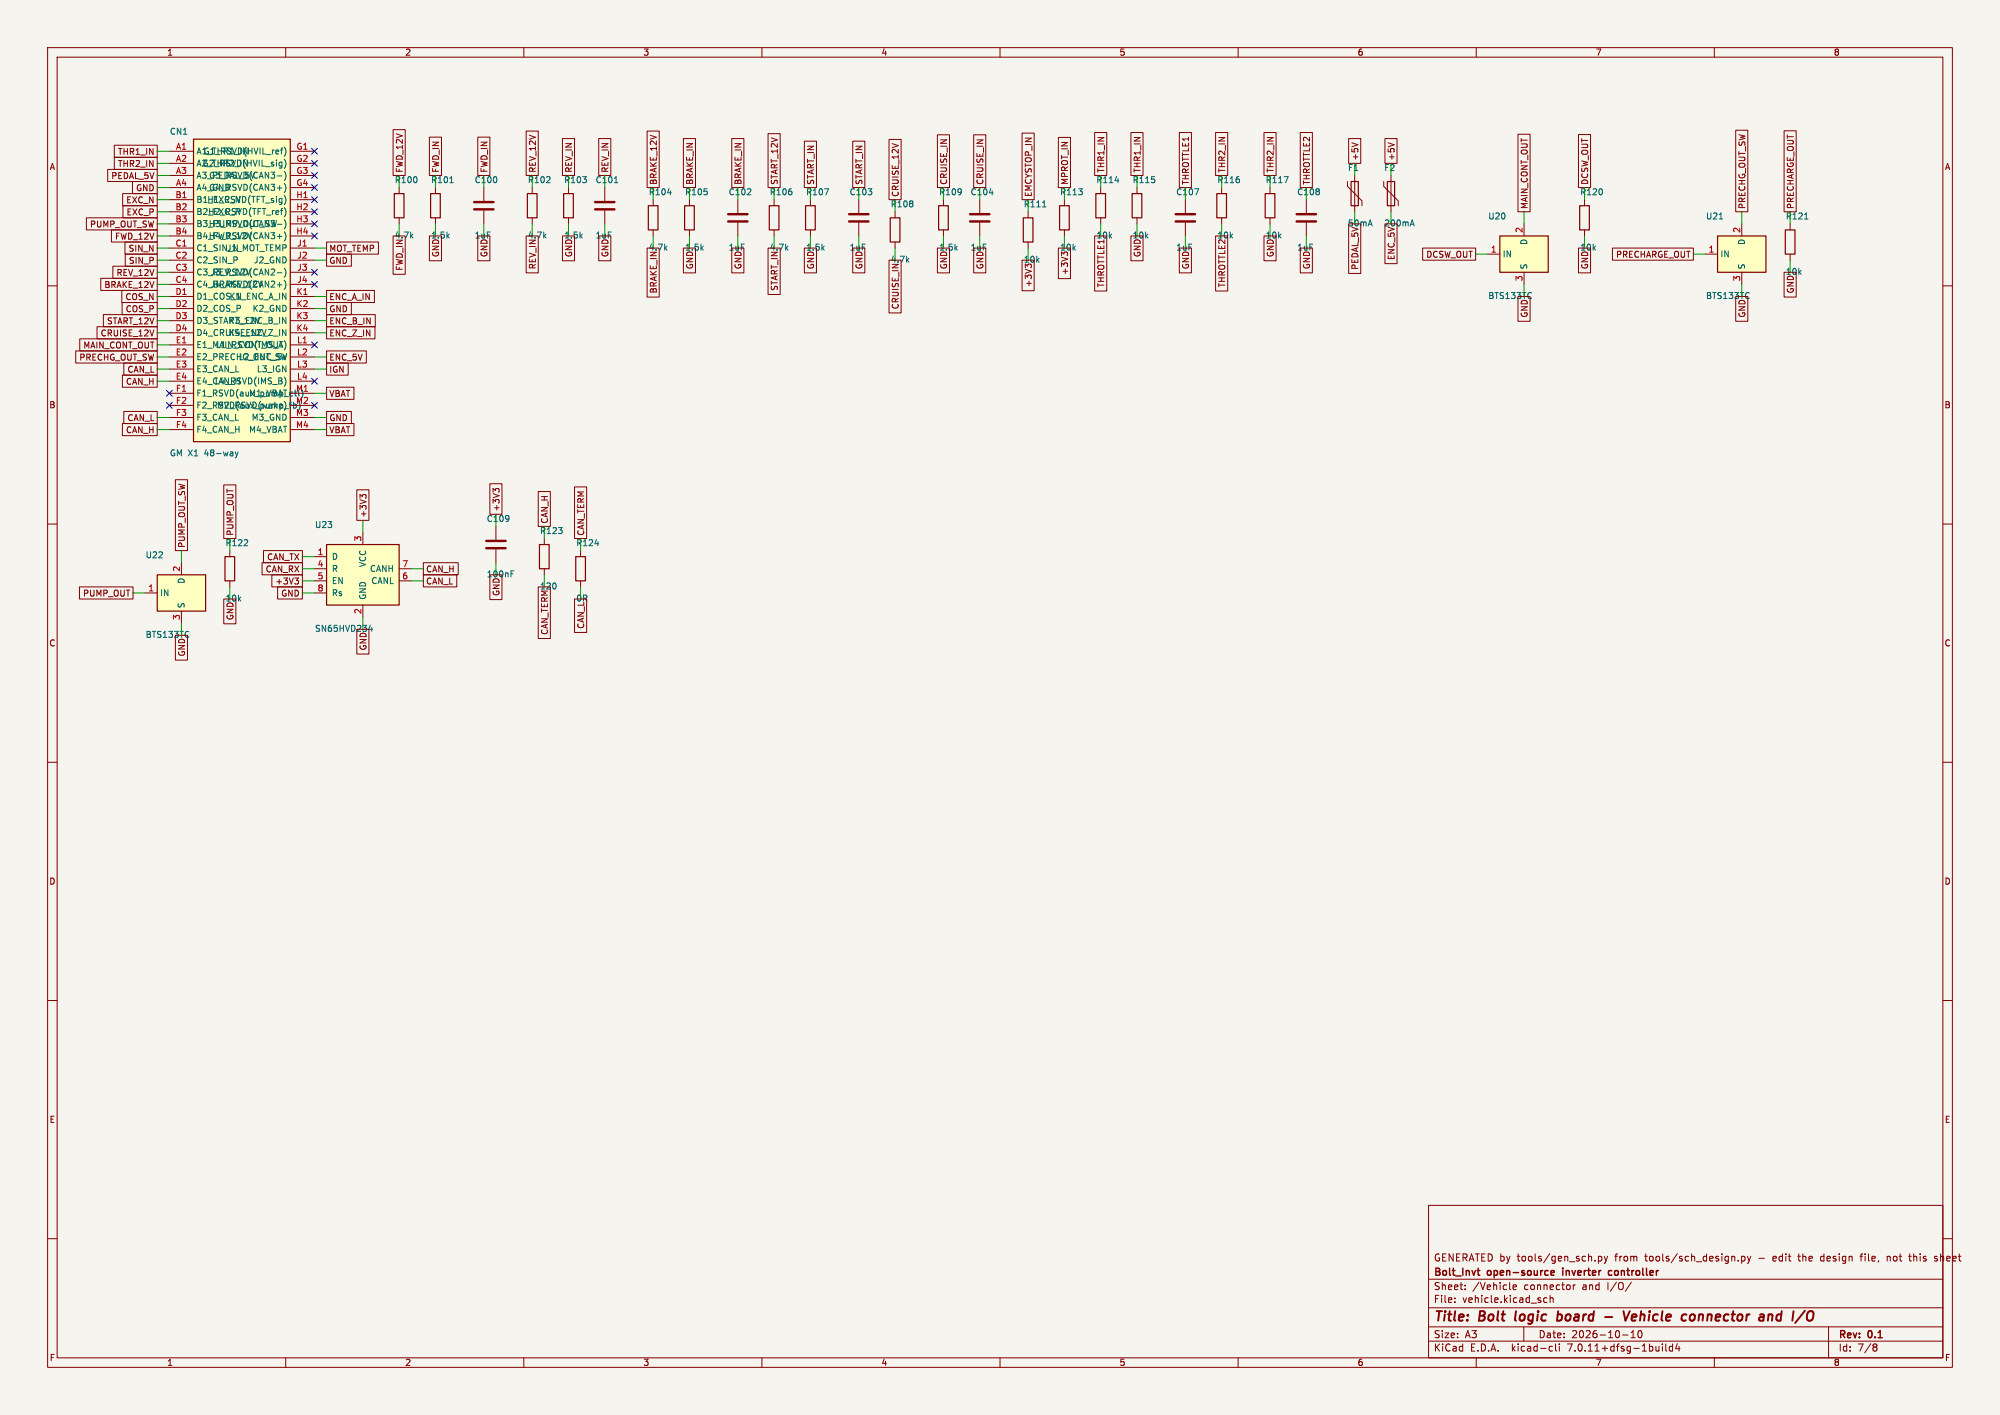
[picture p11: page 7]

3 U21 BTS133TC BRAKE_12V GND REV_IN FWD_IN GND REV_12V REV_IN REV_IN GND BRAKE_IN BRAKE_IN BRAKE_IN GND DCSW_OUT MAIN_CONT_OUT GND FWD_IN

Id: 7/8 Title: Bolt logic board - Vehicle connector and I/O

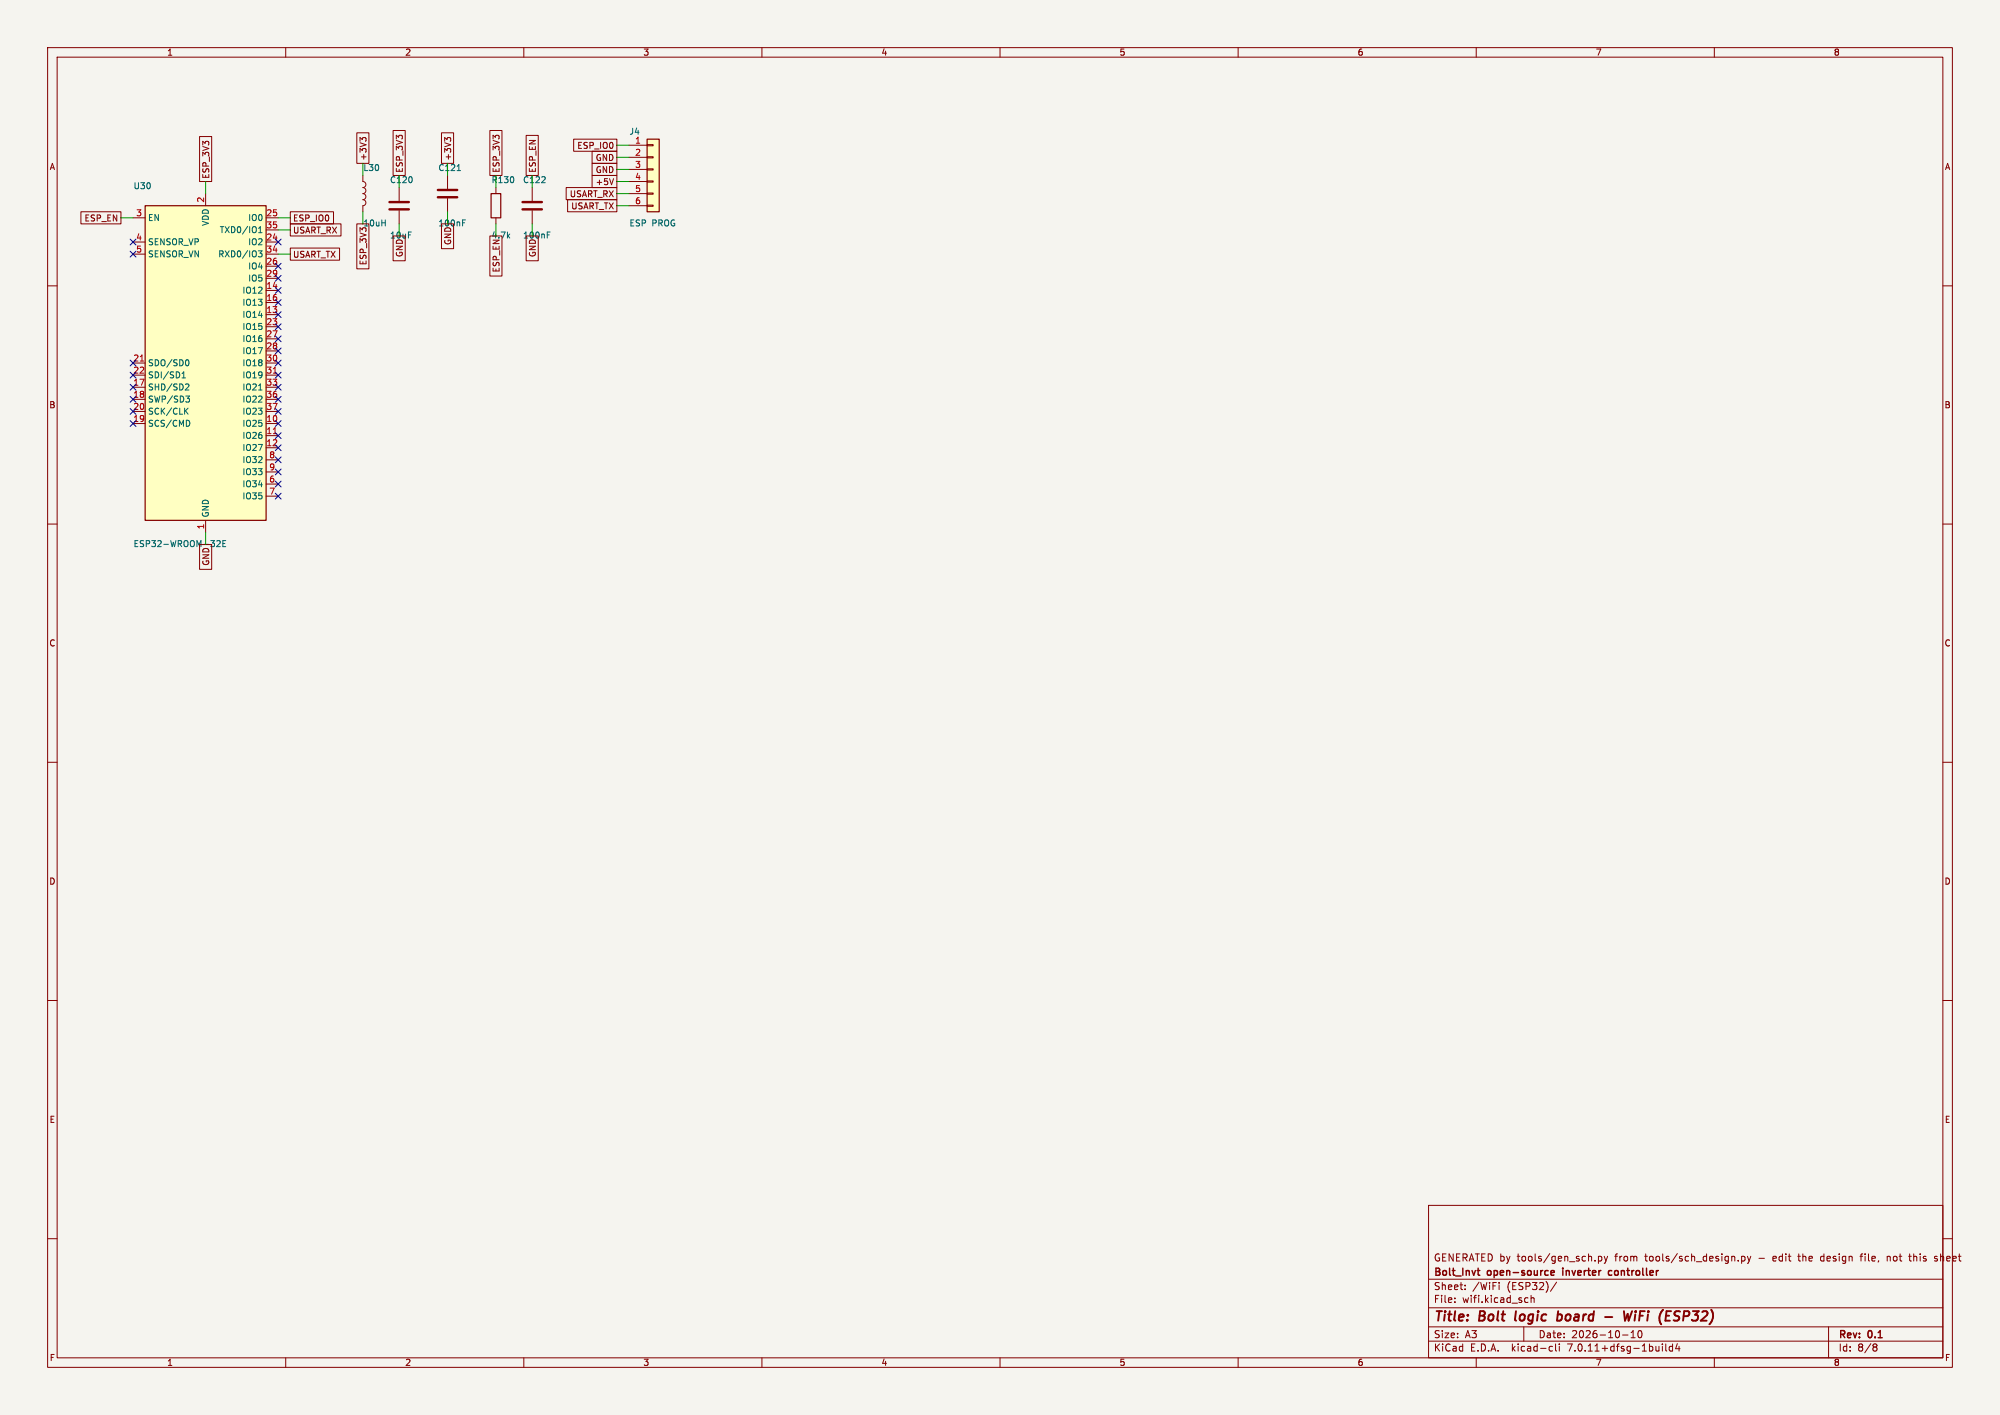
[picture p12: page 8]

2 SCK/CLK 20 SDO/SD0 21 SDI/SD1 22

Id: 8/8 Title: Bolt logic board - WiFi (ESP32) File: wifi.kicad_sch Sheet: /WiFi (ESP32)/
