PSMangelsdorf/Bolt_Invt/V0.1/hardware/bolt_logic/bolt_logic.kicad_pcb

## KiCad design V0.1/hardware/bolt_logic/bolt_logic.kicad_pcb (2026-10-31)

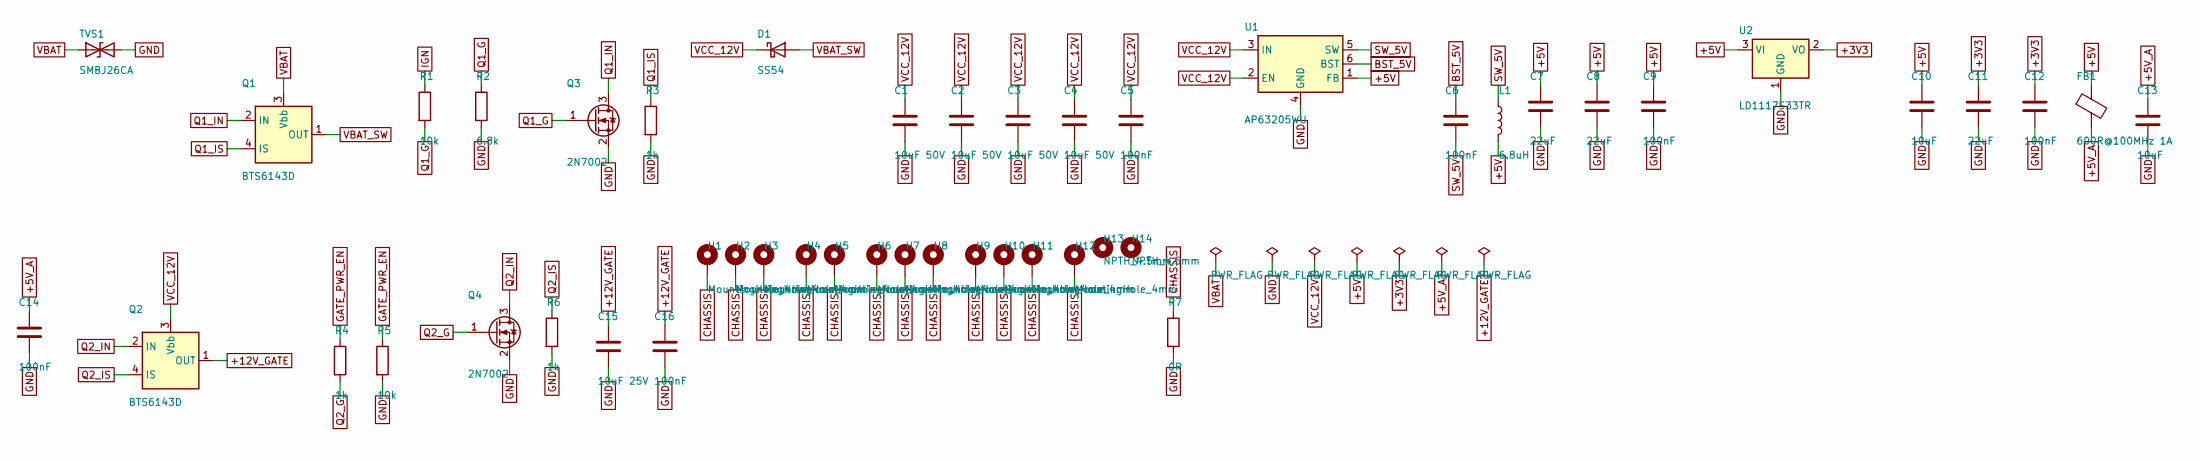
[picture p13: schematic power.kicad_sch, Bolt logic board - Power]

Parts:
C1, C2, C3, C4: 10uF 50V; C_1206_3216Metric
C5, C6, C9, C12, C14, C16: 100nF; C_0805_2012Metric
C7, C8, C11: 22uF; C_1206_3216Metric
C10, C13: 10uF; C_1206_3216Metric
C15: 10uF 25V; C_1206_3216Metric
D1: SS54; D_SMA
FB1: 600R@100MHz 1A; L_0805_2012Metric
H1, H2, H3, H4, H5, H6, H7, H8, H9, H10, H11, H12: MountingHole_4mm; MountingHole_4.0mm_Pad6.5
H13, H14: NPTH_4.5mm
L1: 6.8uH; L_Bourns_SRN6045TA
Q1, Q2: BTS6143D; TO-252-4
Q3, Q4: 2N7002; SOT-23
R1, R5: 10k; R_0805_2012Metric
R2: 6.8k; R_0805_2012Metric
R3, R4, R6: 1k; R_0805_2012Metric
R7: 0R; R_1206_3216Metric
TVS1: SMBJ26CA; D_SMB
U1: AP63205WU; TSOT-23-6
U2: LD1117S33TR; SOT-223-3_TabPin2

Connections:
+3V3: C11.1, C12.1, U2.2 (VO); also elsewhere on the board
+5V: C7.1, C8.1, C9.1, C10.1, FB1.1, L1.2, U1.1 (FB), U2.3 (VI); also elsewhere on the board
+5V_A: C13.1, C14.1, FB1.2; also elsewhere on the board
+12V_GATE: C15.1, C16.1, Q2.1 (OUT), Q2.5 (OUT); also elsewhere on the board
BST_5V: C6.1, U1.6 (BST)
CHASSIS: H1.1, H2.1, H3.1, H4.1, H5.1, H6.1, H7.1, H8.1, H9.1, H10.1, H11.1, H12.1, R7.1
GATE_PWR_EN: R4.1, R5.1; also elsewhere on the board
GND: C1.2, C2.2, C3.2, C4.2, C5.2, C7.2, C8.2, C9.2, C10.2, C11.2, C12.2, C13.2, C14.2, C15.2, C16.2, Q3.2 (S), Q4.2 (S), R2.2, R3.2, R5.2, R6.2, R7.2, TVS1.2 (A2), U1.4 (GND), U2.1 (GND); also elsewhere on the board
IGN: R1.1; also elsewhere on the board
Q1_G: Q3.1 (G), R1.2, R2.1
Q1_IN: Q1.2 (IN), Q3.3 (D)
Q1_IS: Q1.4 (IS), R3.1
Q2_G: Q4.1 (G), R4.2
Q2_IN: Q2.2 (IN), Q4.3 (D)
Q2_IS: Q2.4 (IS), R6.1
SW_5V: C6.2, L1.1, U1.5 (SW)
VBAT: Q1.3 (Vbb), TVS1.1 (A1); also elsewhere on the board
VBAT_SW: D1.2 (A), Q1.1 (OUT), Q1.5 (OUT)
VCC_12V: C1.1, C2.1, C3.1, C4.1, C5.1, D1.1 (K), Q2.3 (Vbb), U1.2 (EN), U1.3 (IN); also elsewhere on the board

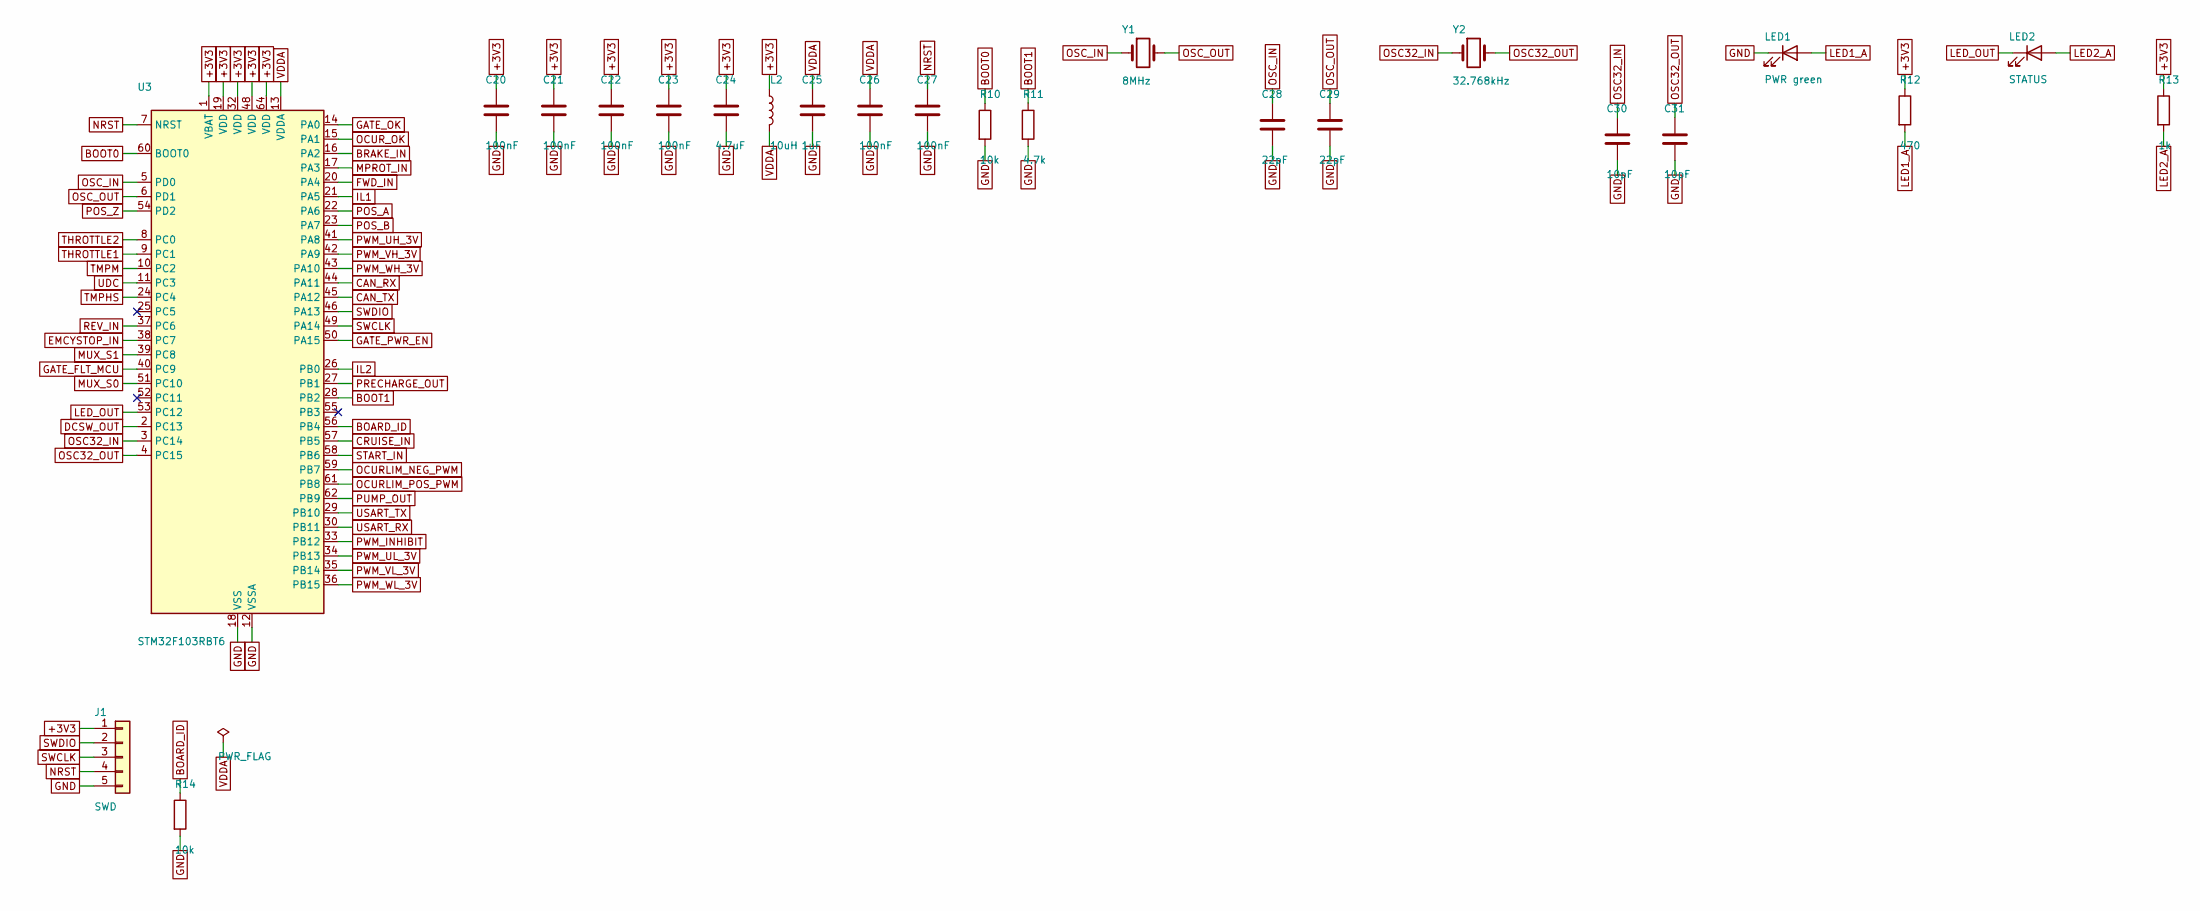
[picture p14: schematic mcu.kicad_sch, Bolt logic board - MCU]

Parts:
C20, C21, C22, C23, C26, C27: 100nF; C_0805_2012Metric
C24: 4.7uF; C_0805_2012Metric
C25: 1uF; C_0805_2012Metric
C28, C29: 22pF; C_0805_2012Metric
C30, C31: 10pF; C_0805_2012Metric
J1: SWD; PinHeader_1x05_P2.54mm_Vertical
L2: 10uH; L_0805_2012Metric
LED1: PWR green; LED_0805_2012Metric
LED2: STATUS; LED_0805_2012Metric
R10, R14: 10k; R_0805_2012Metric
R11: 4.7k; R_0805_2012Metric
R12: 470; R_0805_2012Metric
R13: 1k; R_0805_2012Metric
U3: STM32F103RBT6; LQFP-64_10x10mm_P0.5mm
Y1: 8MHz; Crystal_SMD_5032-2Pin_5.0x3.2mm
Y2: 32.768kHz; Crystal_SMD_3215-2Pin_3.2x1.5mm

Connections:
+3V3: C20.1, C21.1, C22.1, C23.1, C24.1, J1.1, L2.1, R12.1, R13.1, U3.1 (VBAT), U3.19 (VDD), U3.32 (VDD), U3.48 (VDD), U3.64 (VDD); also elsewhere on the board
BOARD_ID: R14.1, U3.56 (PB4)
BOOT0: R10.1, U3.60 (BOOT0)
BOOT1: R11.1, U3.28 (PB2)
BRAKE_IN: U3.16 (PA2); also elsewhere on the board
CAN_RX: U3.44 (PA11); also elsewhere on the board
CAN_TX: U3.45 (PA12); also elsewhere on the board
CRUISE_IN: U3.57 (PB5); also elsewhere on the board
DCSW_OUT: U3.2 (PC13); also elsewhere on the board
EMCYSTOP_IN: U3.38 (PC7); also elsewhere on the board
FWD_IN: U3.20 (PA4); also elsewhere on the board
GATE_FLT_MCU: U3.40 (PC9); also elsewhere on the board
GATE_OK: U3.14 (PA0); also elsewhere on the board
GATE_PWR_EN: U3.50 (PA15); also elsewhere on the board
GND: C20.2, C21.2, C22.2, C23.2, C24.2, C25.2, C26.2, C27.2, C28.2, C29.2, C30.2, C31.2, J1.5, LED1.1 (K), R10.2, R11.2, R14.2, U3.12 (VSSA), U3.18 (VSS), U3.31 (VSS), U3.47 (VSS), U3.63 (VSS); also elsewhere on the board
IL1: U3.21 (PA5); also elsewhere on the board
IL2: U3.26 (PB0); also elsewhere on the board
LED1_A: LED1.2 (A), R12.2
LED2_A: LED2.2 (A), R13.2
LED_OUT: LED2.1 (K), U3.53 (PC12)
MPROT_IN: U3.17 (PA3); also elsewhere on the board
MUX_S0: U3.51 (PC10); also elsewhere on the board
MUX_S1: U3.39 (PC8); also elsewhere on the board
NRST: C27.1, J1.4, U3.7 (NRST)
OCURLIM_NEG_PWM: U3.59 (PB7); also elsewhere on the board
OCURLIM_POS_PWM: U3.61 (PB8); also elsewhere on the board
OCUR_OK: U3.15 (PA1); also elsewhere on the board
OSC32_IN: C30.1, U3.3 (PC14), Y2.1
OSC32_OUT: C31.1, U3.4 (PC15), Y2.2
OSC_IN: C28.1, U3.5 (PD0), Y1.1
OSC_OUT: C29.1, U3.6 (PD1), Y1.2
POS_A: U3.22 (PA6); also elsewhere on the board
POS_B: U3.23 (PA7); also elsewhere on the board
POS_Z: U3.54 (PD2); also elsewhere on the board
PRECHARGE_OUT: U3.27 (PB1); also elsewhere on the board
PUMP_OUT: U3.62 (PB9); also elsewhere on the board
PWM_INHIBIT: U3.33 (PB12); also elsewhere on the board
PWM_UH_3V: U3.41 (PA8); also elsewhere on the board
PWM_UL_3V: U3.34 (PB13); also elsewhere on the board
PWM_VH_3V: U3.42 (PA9); also elsewhere on the board
PWM_VL_3V: U3.35 (PB14); also elsewhere on the board
PWM_WH_3V: U3.43 (PA10); also elsewhere on the board
PWM_WL_3V: U3.36 (PB15); also elsewhere on the board
REV_IN: U3.37 (PC6); also elsewhere on the board
START_IN: U3.58 (PB6); also elsewhere on the board
SWCLK: J1.3, U3.49 (PA14)
SWDIO: J1.2, U3.46 (PA13)
THROTTLE1: U3.9 (PC1); also elsewhere on the board
THROTTLE2: U3.8 (PC0); also elsewhere on the board
TMPHS: U3.24 (PC4); also elsewhere on the board
TMPM: U3.10 (PC2); also elsewhere on the board
UDC: U3.11 (PC3); also elsewhere on the board
USART_RX: U3.30 (PB11); also elsewhere on the board
USART_TX: U3.29 (PB10); also elsewhere on the board
VDDA: C25.1, C26.1, L2.2, U3.13 (VDDA)

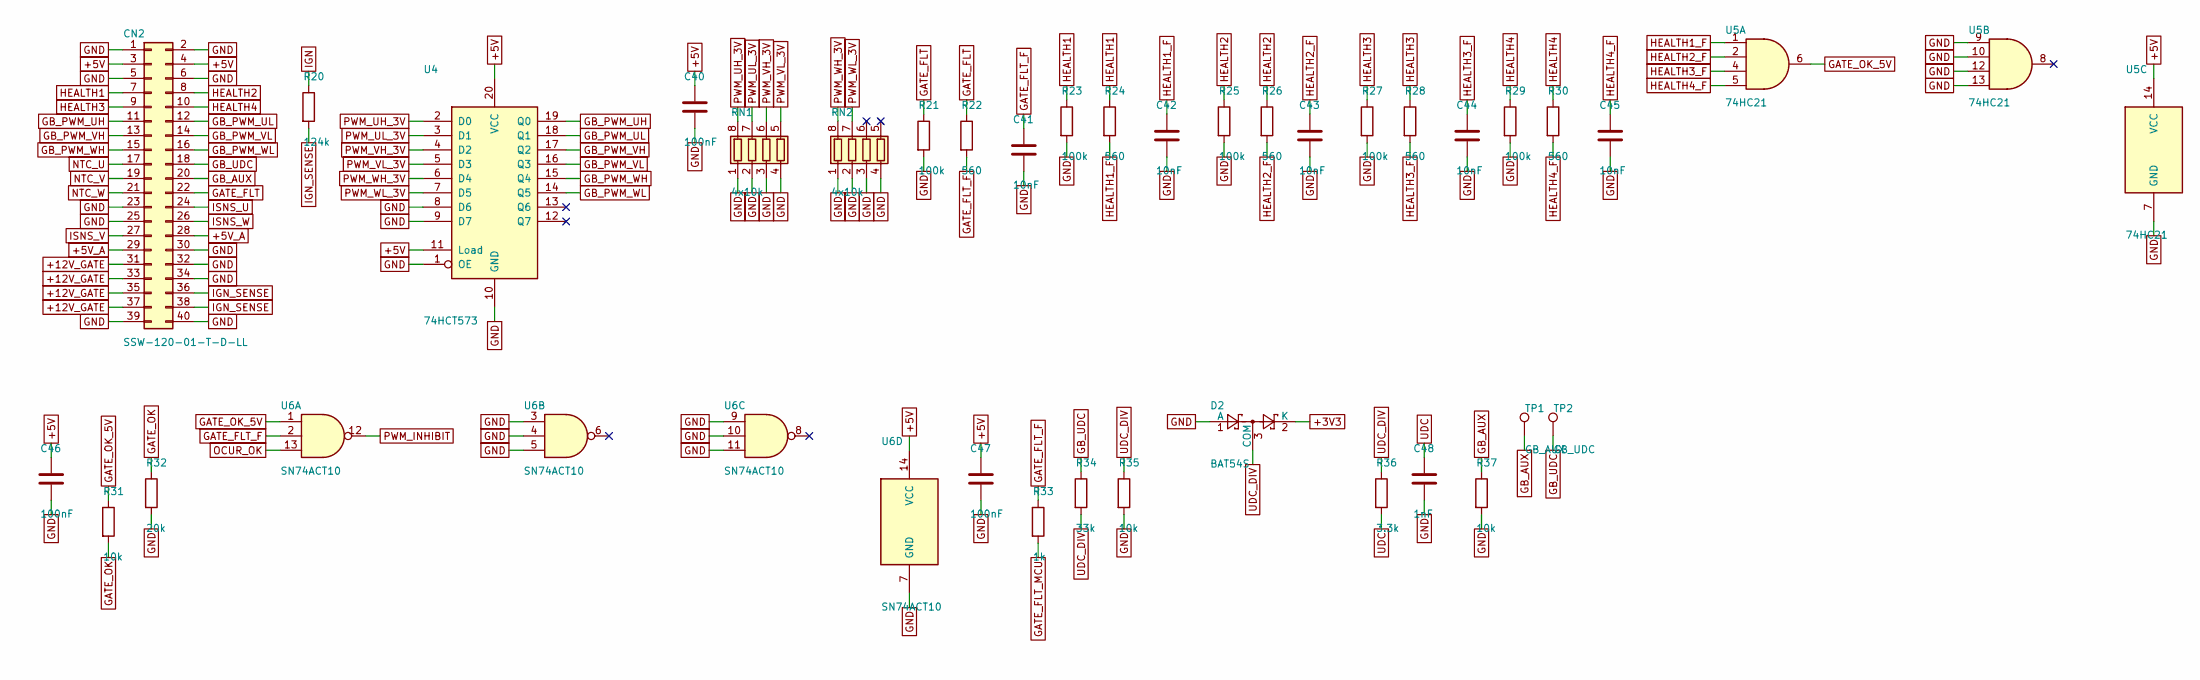
[picture p15: schematic gate_if.kicad_sch, Bolt logic board - Gate interface]

Parts:
C40, C46, C47: 100nF; C_0805_2012Metric
C41, C42, C43, C44, C45: 10nF; C_0805_2012Metric
C48: 1nF; C_0805_2012Metric
CN2: SSW-120-01-T-D-LL; CN2_2x20_P2.54_Receptacle_Back
D2: BAT54S; SOT-23
R20: 124k; R_0805_2012Metric
R21, R23, R25, R27, R29: 100k; R_0805_2012Metric
R22, R24, R26, R28, R30: 560; R_0805_2012Metric
R31, R35, R37: 10k; R_0805_2012Metric
R32: 20k; R_0805_2012Metric
R33: 1k; R_0805_2012Metric
R34: 33k; R_0805_2012Metric
R36: 3.3k; R_0805_2012Metric
RN1, RN2: 4x10k; R_Array_Convex_4x0603
TP1: GB_AUX; TestPoint_Pad_D1.5mm
TP2: GB_UDC; TestPoint_Pad_D1.5mm
U4: 74HCT573; SOIC-20W_7.5x12.8mm_P1.27mm
U5: 74HC21; SOIC-14_3.9x8.7mm_P1.27mm
U6: SN74ACT10; SOIC-14_3.9x8.7mm_P1.27mm

Connections:
+3V3: D2.2 (K); also elsewhere on the board
+5V: C40.1, C46.1, C47.1, CN2.3, CN2.4, U4.11 (Load), U4.20 (VCC), U5.14 (VCC), U6.14 (VCC); also elsewhere on the board
+5V_A: CN2.28, CN2.29; also elsewhere on the board
+12V_GATE: CN2.31, CN2.33, CN2.35, CN2.37; also elsewhere on the board
GATE_FLT: CN2.22, R21.1, R22.1
GATE_FLT_F: C41.1, R22.2, R33.1, U6.2
GATE_FLT_MCU: R33.2; also elsewhere on the board
GATE_OK: R31.2, R32.1; also elsewhere on the board
GATE_OK_5V: R31.1, U5.6, U6.1
GB_AUX: CN2.20, R37.1, TP1.1
GB_PWM_UH: CN2.11, U4.19 (Q0)
GB_PWM_UL: CN2.12, U4.18 (Q1)
GB_PWM_VH: CN2.13, U4.17 (Q2)
GB_PWM_VL: CN2.14, U4.16 (Q3)
GB_PWM_WH: CN2.15, U4.15 (Q4)
GB_PWM_WL: CN2.16, U4.14 (Q5)
GB_UDC: CN2.18, R34.1, TP2.1
GND: C40.2, C41.2, C42.2, C43.2, C44.2, C45.2, C46.2, C47.2, C48.2, CN2.1, CN2.2, CN2.5, CN2.6, CN2.23, CN2.25, CN2.30, CN2.32, CN2.34, CN2.39, CN2.40, D2.1 (A), R21.2, R23.2, R25.2, R27.2, R29.2, R32.2, R35.2, R37.2, RN1.1 (R1.1), RN1.2 (R2.1), RN1.3 (R3.1), RN1.4 (R4.1), RN2.1 (R1.1), RN2.2 (R2.1), RN2.3 (R3.1), RN2.4 (R4.1), U4.1 (OE), U4.8 (D6), U4.9 (D7), U4.10 (GND), U5.7 (GND), U5.9, U5.10, U5.12, U5.13, U6.3, U6.4, U6.5, U6.7 (GND), U6.9, U6.10, U6.11; also elsewhere on the board
HEALTH1: CN2.7, R23.1, R24.1
HEALTH1_F: C42.1, R24.2, U5.1
HEALTH2: CN2.8, R25.1, R26.1
HEALTH2_F: C43.1, R26.2, U5.2
HEALTH3: CN2.9, R27.1, R28.1
HEALTH3_F: C44.1, R28.2, U5.4
HEALTH4: CN2.10, R29.1, R30.1
HEALTH4_F: C45.1, R30.2, U5.5
IGN: R20.1; also elsewhere on the board
IGN_SENSE: CN2.36, CN2.38, R20.2
ISNS_U: CN2.24; also elsewhere on the board
ISNS_V: CN2.27; also elsewhere on the board
ISNS_W: CN2.26; also elsewhere on the board
NTC_U: CN2.17; also elsewhere on the board
NTC_V: CN2.19; also elsewhere on the board
NTC_W: CN2.21; also elsewhere on the board
OCUR_OK: U6.13; also elsewhere on the board
PWM_INHIBIT: U6.12; also elsewhere on the board
PWM_UH_3V: RN1.8 (R1.2), U4.2 (D0); also elsewhere on the board
PWM_UL_3V: RN1.7 (R2.2), U4.3 (D1); also elsewhere on the board
PWM_VH_3V: RN1.6 (R3.2), U4.4 (D2); also elsewhere on the board
PWM_VL_3V: RN1.5 (R4.2), U4.5 (D3); also elsewhere on the board
PWM_WH_3V: RN2.8 (R1.2), U4.6 (D4); also elsewhere on the board
PWM_WL_3V: RN2.7 (R2.2), U4.7 (D5); also elsewhere on the board
UDC: C48.1, R36.2; also elsewhere on the board
UDC_DIV: D2.3 (COM), R34.2, R35.1, R36.1

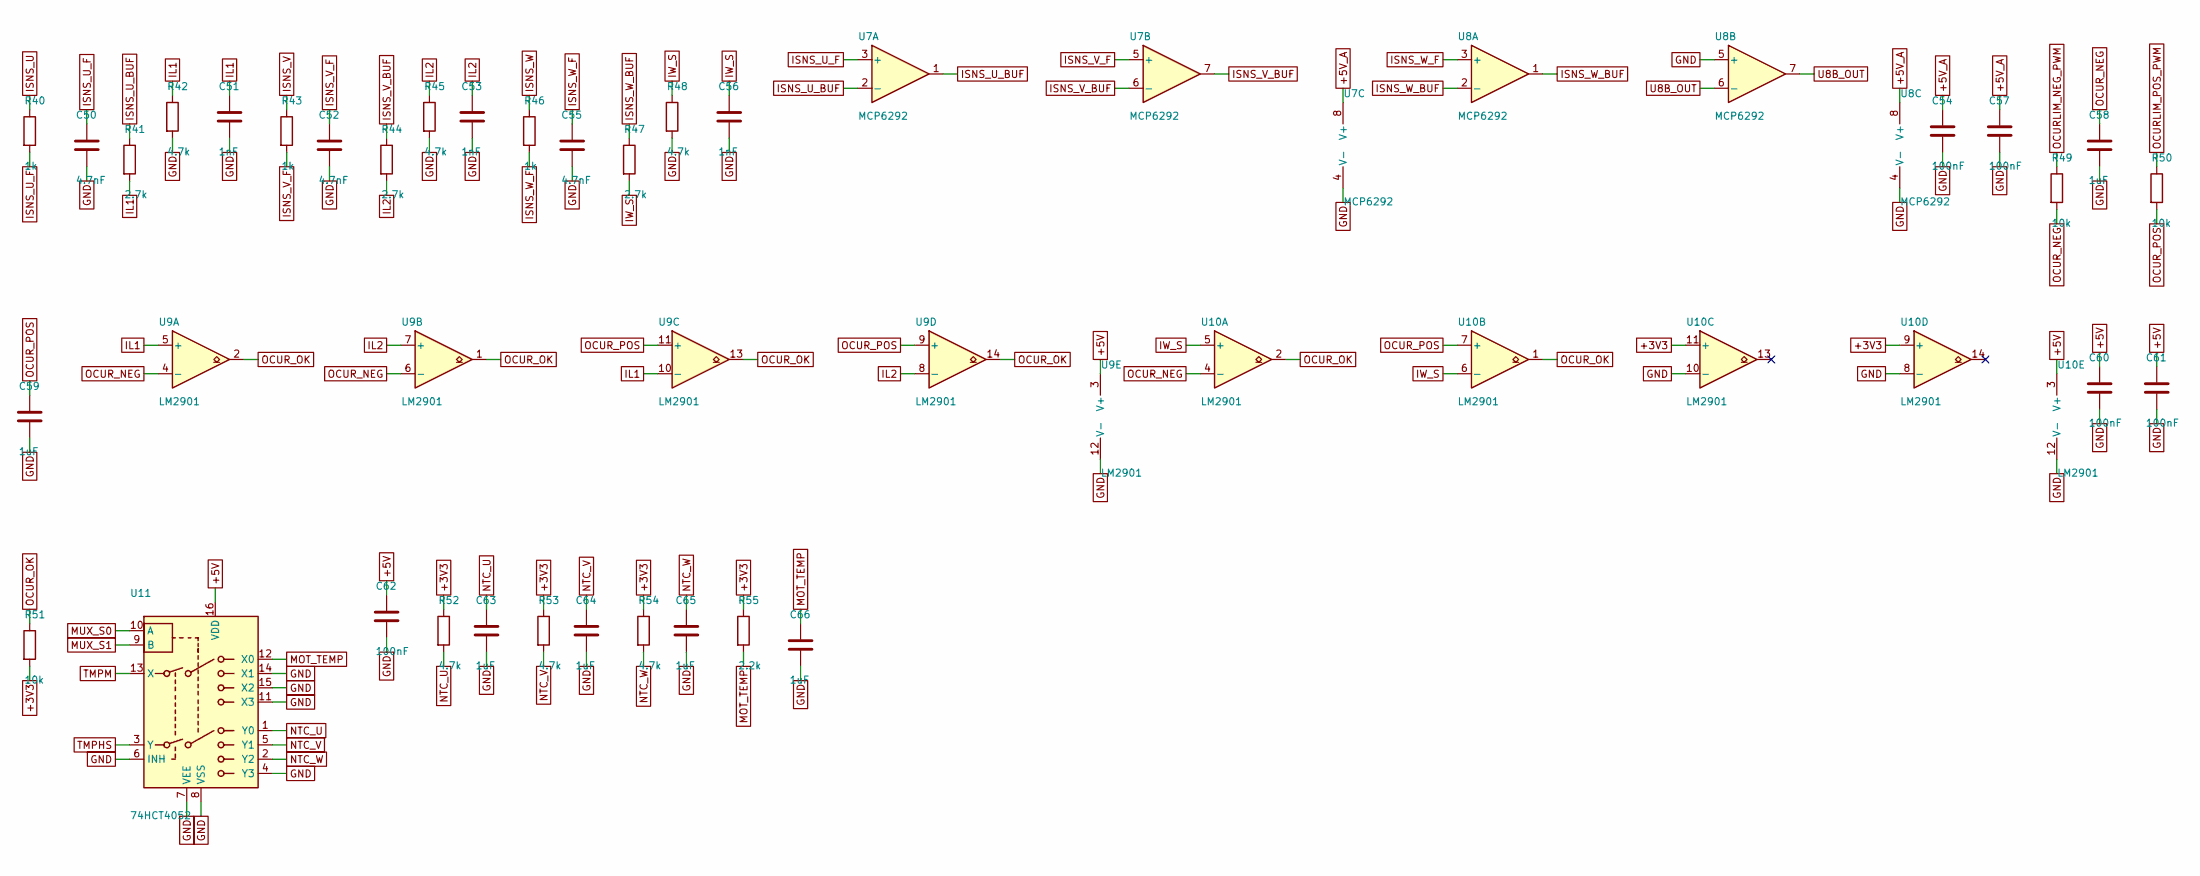
[picture p16: schematic analog.kicad_sch, Bolt logic board - Current sense, overcurrent, temperature]

Parts:
C50, C52, C55: 4.7nF; C_0805_2012Metric
C51, C53, C56: 1nF; C_0805_2012Metric
C54, C57, C60, C61, C62: 100nF; C_0805_2012Metric
C58, C59, C63, C64, C65, C66: 1uF; C_0805_2012Metric
R40, R43, R46: 1k; R_0805_2012Metric
R41, R44, R47: 2.7k; R_0805_2012Metric
R42, R45, R48, R52, R53, R54: 4.7k; R_0805_2012Metric
R49, R50, R51: 10k; R_0805_2012Metric
R55: 2.2k; R_0805_2012Metric
U7, U8: MCP6292; SOIC-8_3.9x4.9mm_P1.27mm
U9, U10: LM2901; SOIC-14_3.9x8.7mm_P1.27mm
U11: 74HCT4052; SOIC-16_3.9x9.9mm_P1.27mm

Connections:
+3V3: R51.2, R52.1, R53.1, R54.1, R55.1, U10.9 (+), U10.11 (+); also elsewhere on the board
+5V: C60.1, C61.1, C62.1, U9.3 (V+), U10.3 (V+), U11.16 (VDD); also elsewhere on the board
+5V_A: C54.1, C57.1, U7.8 (V+), U8.8 (V+); also elsewhere on the board
GND: C50.2, C51.2, C52.2, C53.2, C54.2, C55.2, C56.2, C57.2, C58.2, C59.2, C60.2, C61.2, C62.2, C63.2, C64.2, C65.2, C66.2, R42.2, R45.2, R48.2, U7.4 (V-), U8.4 (V-), U8.5 (+), U9.12 (V-), U10.8 (-), U10.10 (-), U10.12 (V-), U11.4 (Y3), U11.6 (INH), U11.7 (VEE), U11.8 (VSS), U11.11 (X3), U11.14 (X1), U11.15 (X2); also elsewhere on the board
IL1: C51.1, R41.2, R42.1, U9.5 (+), U9.10 (-); also elsewhere on the board
IL2: C53.1, R44.2, R45.1, U9.7 (+), U9.8 (-); also elsewhere on the board
ISNS_U: R40.1; also elsewhere on the board
ISNS_U_BUF: R41.1, U7.1, U7.2 (-)
ISNS_U_F: C50.1, R40.2, U7.3 (+)
ISNS_V: R43.1; also elsewhere on the board
ISNS_V_BUF: R44.1, U7.6 (-), U7.7
ISNS_V_F: C52.1, R43.2, U7.5 (+)
ISNS_W: R46.1; also elsewhere on the board
ISNS_W_BUF: R47.1, U8.1, U8.2 (-)
ISNS_W_F: C55.1, R46.2, U8.3 (+)
IW_S: C56.1, R47.2, R48.1, U10.5 (+), U10.6 (-)
MOT_TEMP: C66.1, R55.2, U11.12 (X0); also elsewhere on the board
MUX_S0: U11.10 (A); also elsewhere on the board
MUX_S1: U11.9 (B); also elsewhere on the board
NTC_U: C63.1, R52.2, U11.1 (Y0); also elsewhere on the board
NTC_V: C64.1, R53.2, U11.5 (Y1); also elsewhere on the board
NTC_W: C65.1, R54.2, U11.2 (Y2); also elsewhere on the board
OCURLIM_NEG_PWM: R49.1; also elsewhere on the board
OCURLIM_POS_PWM: R50.1; also elsewhere on the board
OCUR_NEG: C58.1, R49.2, U9.4 (-), U9.6 (-), U10.4 (-)
OCUR_OK: R51.1, U9.1, U9.2, U9.13, U9.14, U10.1, U10.2; also elsewhere on the board
OCUR_POS: C59.1, R50.2, U9.9 (+), U9.11 (+), U10.7 (+)
TMPHS: U11.3 (Y); also elsewhere on the board
TMPM: U11.13 (X); also elsewhere on the board
U8B_OUT: U8.6 (-), U8.7

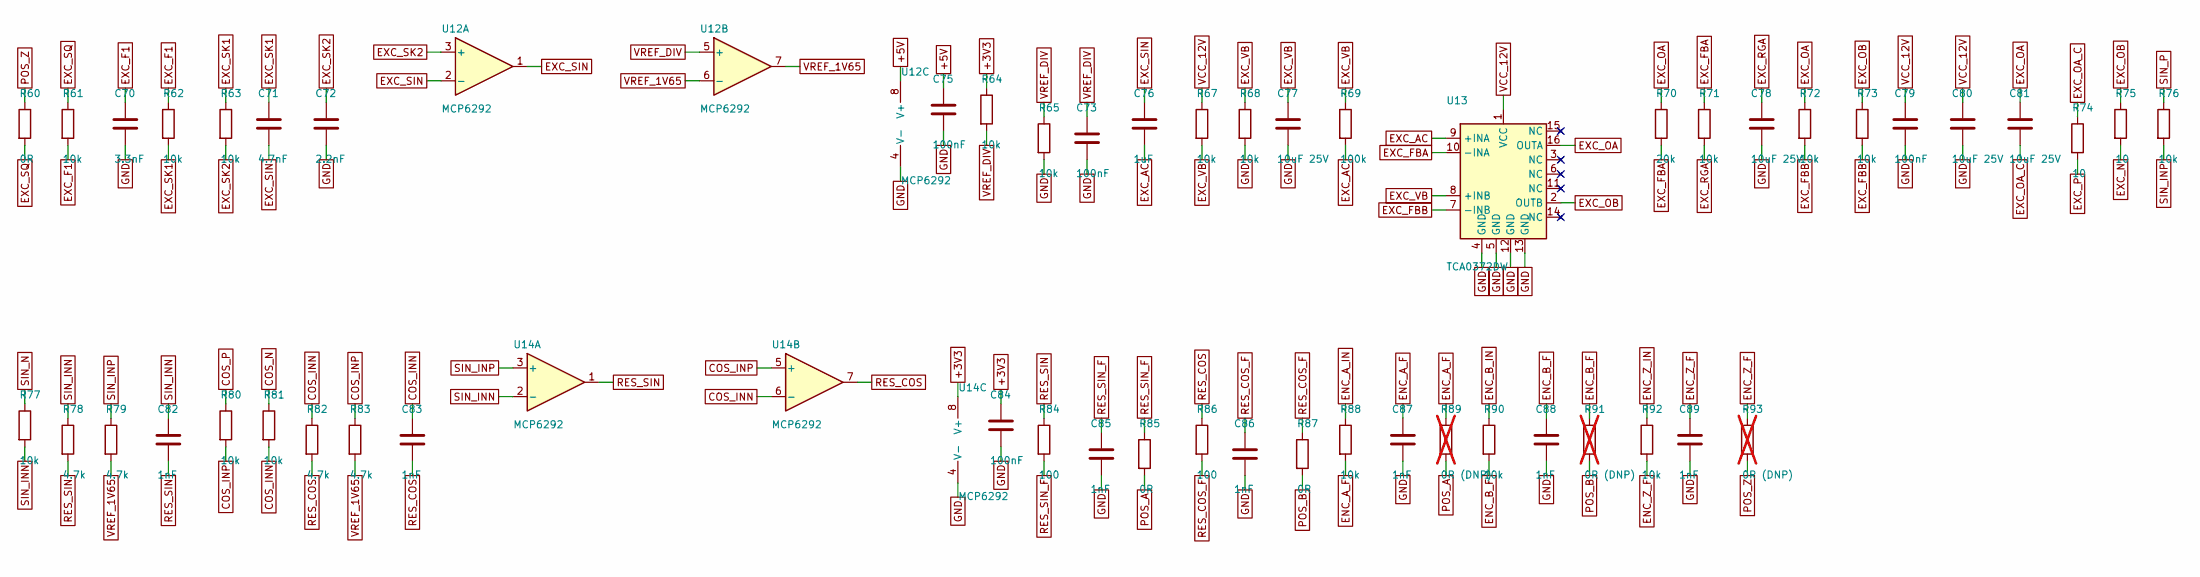
[picture p17: schematic resolver.kicad_sch, Bolt logic board - Resolver / encoder]

Parts:
C70: 3.3nF; C_0805_2012Metric
C71: 4.7nF; C_0805_2012Metric
C72: 2.2nF; C_0805_2012Metric
C73, C75, C79, C84: 100nF; C_0805_2012Metric
C76: 1uF; C_0805_2012Metric
C77, C78, C80, C81: 10uF 25V; C_1206_3216Metric
C82, C83, C85, C86, C87, C88, C89: 1nF; C_0805_2012Metric
R60, R85, R87: 0R; R_0805_2012Metric
R61, R62, R63, R64, R65, R67, R68, R71, R72, R73, R76, R77, R80, R81, R88, R90, R92: 10k; R_0805_2012Metric
R69: 100k; R_0805_2012Metric
R70: 20k; R_0805_2012Metric
R74, R75: 10; R_1206_3216Metric
R78, R79, R82, R83: 4.7k; R_0805_2012Metric
R84, R86: 100; R_0805_2012Metric
R89, R91, R93: 0R (DNP); R_0805_2012Metric; not fitted
U12, U14: MCP6292; SOIC-8_3.9x4.9mm_P1.27mm
U13: TCA0372DW; SOIC-16W_7.5x10.3mm_P1.27mm

Connections:
+3V3: C84.1, R64.1, U14.8 (V+); also elsewhere on the board
+5V: C75.1, U12.8 (V+); also elsewhere on the board
COS_INN: C83.1, R81.2, R82.1, U14.6 (-)
COS_INP: R80.2, R83.1, U14.5 (+)
COS_N: R81.1; also elsewhere on the board
COS_P: R80.1; also elsewhere on the board
ENC_A_F: C87.1, R88.2, R89.1
ENC_A_IN: R88.1; also elsewhere on the board
ENC_B_F: C88.1, R90.2, R91.1
ENC_B_IN: R90.1; also elsewhere on the board
ENC_Z_F: C89.1, R92.2, R93.1
ENC_Z_IN: R92.1; also elsewhere on the board
EXC_AC: C76.2, R69.2, U13.9 (+INA)
EXC_F1: C70.1, R61.2, R62.1
EXC_FBA: R70.2, R71.1, U13.10 (-INA)
EXC_FBB: R72.2, R73.2, U13.7 (-INB)
EXC_N: R75.2; also elsewhere on the board
EXC_OA: C81.1, R70.1, R72.1, U13.16 (OUTA)
EXC_OA_C: C81.2, R74.1
EXC_OB: R73.1, R75.1, U13.2 (OUTB)
EXC_P: R74.2; also elsewhere on the board
EXC_RGA: C78.1, R71.2
EXC_SIN: C71.2, C76.1, U12.1, U12.2 (-)
EXC_SK1: C71.1, R62.2, R63.1
EXC_SK2: C72.1, R63.2, U12.3 (+)
EXC_SQ: R60.2, R61.1
EXC_VB: C77.1, R67.2, R68.1, R69.1, U13.8 (+INB)
GND: C70.2, C72.2, C73.2, C75.2, C77.2, C78.2, C79.2, C80.2, C84.2, C85.2, C86.2, C87.2, C88.2, C89.2, R65.2, R68.2, U12.4 (V-), U13.4 (GND), U13.5 (GND), U13.12 (GND), U13.13 (GND), U14.4 (V-); also elsewhere on the board
POS_A: R85.2, R89.2; also elsewhere on the board
POS_B: R87.2, R91.2; also elsewhere on the board
POS_Z: R60.1, R93.2; also elsewhere on the board
RES_COS: C83.2, R82.2, R86.1, U14.7
RES_COS_F: C86.1, R86.2, R87.1
RES_SIN: C82.2, R78.2, R84.1, U14.1
RES_SIN_F: C85.1, R84.2, R85.1
SIN_INN: C82.1, R77.2, R78.1, U14.2 (-)
SIN_INP: R76.2, R79.1, U14.3 (+)
SIN_N: R77.1; also elsewhere on the board
SIN_P: R76.1; also elsewhere on the board
VCC_12V: C79.1, C80.1, R67.1, U13.1 (VCC); also elsewhere on the board
VREF_1V65: R79.2, R83.2, U12.6 (-), U12.7
VREF_DIV: C73.1, R64.2, R65.1, U12.5 (+)

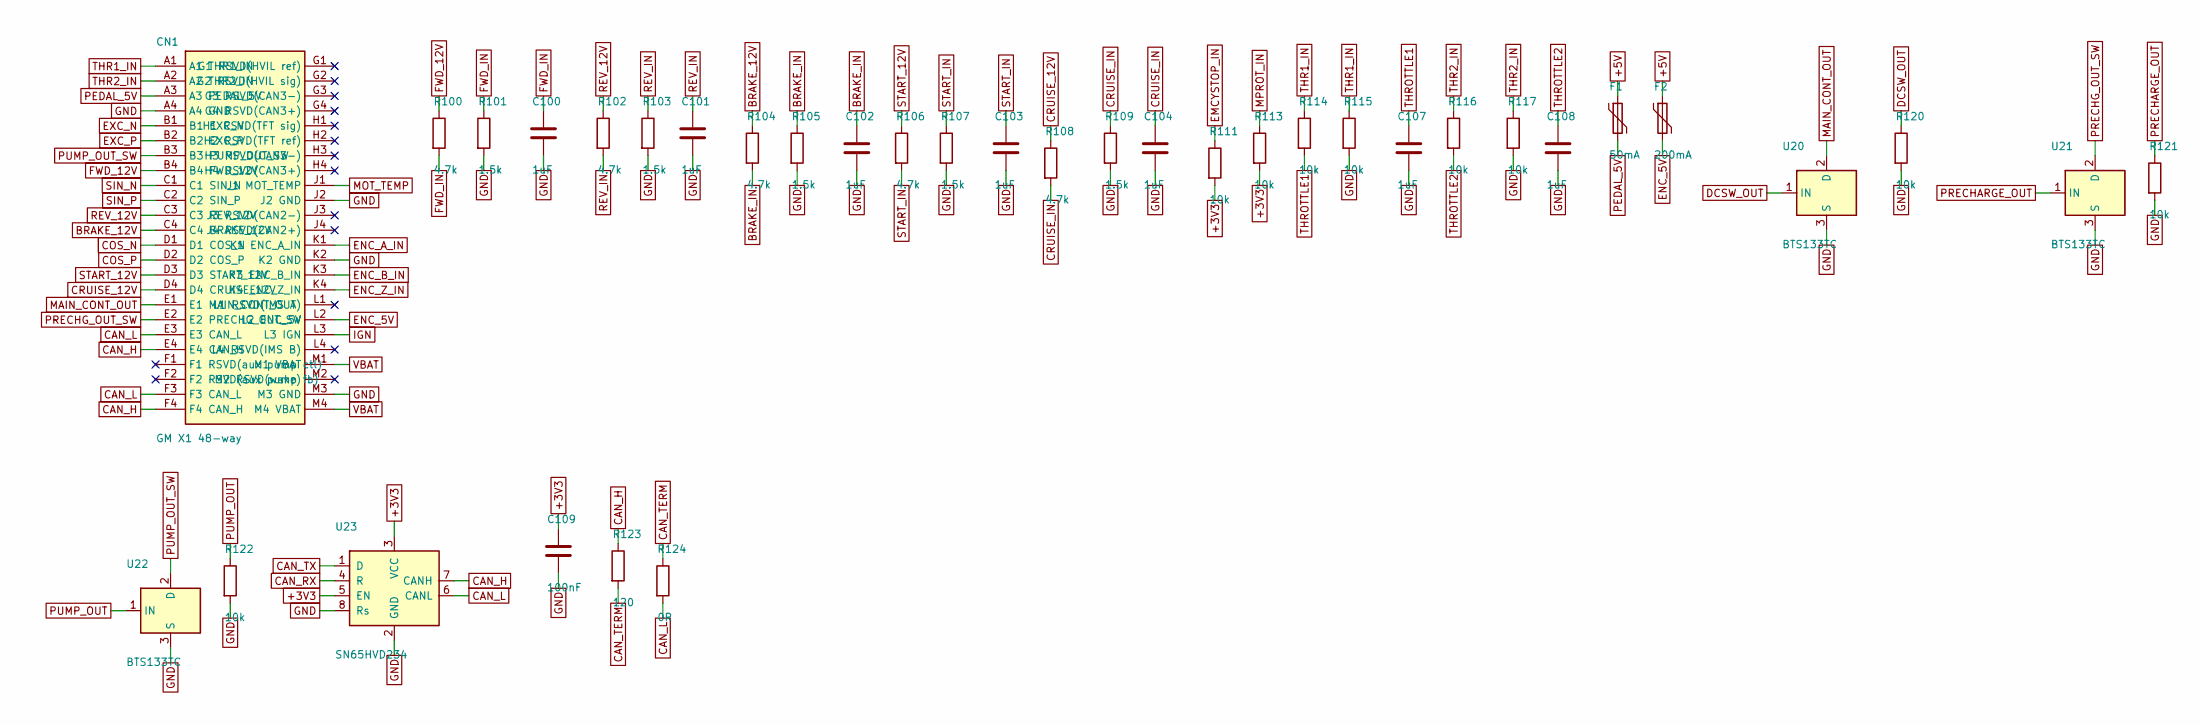
[picture p18: schematic vehicle.kicad_sch, Bolt logic board - Vehicle connector and I/O]

Parts:
C100, C101, C102, C103, C104, C107, C108: 1uF; C_0805_2012Metric
C109: 100nF; C_0805_2012Metric
CN1: GM X1 48-way; CN1_GM_48pos_4x12
F1: 50mA; Fuse_1206_3216Metric
F2: 200mA; Fuse_1206_3216Metric
R100, R102, R104, R106, R108: 4.7k; R_0805_2012Metric
R101, R103, R105, R107, R109: 1.5k; R_0805_2012Metric
R111, R113, R114, R115, R116, R117, R120, R121, R122: 10k; R_0805_2012Metric
R123: 120; R_0805_2012Metric
R124: 0R; R_0805_2012Metric
U20, U21, U22: BTS133TC; TO-263-2
U23: SN65HVD234; SOIC-8_3.9x4.9mm_P1.27mm

Connections:
+3V3: C109.1, R111.2, R113.2, U23.3 (VCC), U23.5 (EN); also elsewhere on the board
+5V: F1.1, F2.1; also elsewhere on the board
BRAKE_12V: CN1.C4 (C4 BRAKE_12V), R104.1
BRAKE_IN: C102.1, R104.2, R105.1; also elsewhere on the board
CAN_H: CN1.E4 (E4 CAN_H), CN1.F4 (F4 CAN_H), R123.1, U23.7 (CANH)
CAN_L: CN1.E3 (E3 CAN_L), CN1.F3 (F3 CAN_L), R124.2, U23.6 (CANL)
CAN_RX: U23.4 (R); also elsewhere on the board
CAN_TERM: R123.2, R124.1
CAN_TX: U23.1 (D); also elsewhere on the board
COS_N: CN1.D1 (D1 COS_N); also elsewhere on the board
COS_P: CN1.D2 (D2 COS_P); also elsewhere on the board
CRUISE_12V: CN1.D4 (D4 CRUISE_12V), R108.1
CRUISE_IN: C104.1, R108.2, R109.1; also elsewhere on the board
DCSW_OUT: R120.1, U20.1 (IN); also elsewhere on the board
EMCYSTOP_IN: R111.1; also elsewhere on the board
ENC_5V: CN1.L2 (L2 ENC_5V), F2.2
ENC_A_IN: CN1.K1 (K1 ENC_A_IN); also elsewhere on the board
ENC_B_IN: CN1.K3 (K3 ENC_B_IN); also elsewhere on the board
ENC_Z_IN: CN1.K4 (K4 ENC_Z_IN); also elsewhere on the board
EXC_N: CN1.B1 (B1 EXC_N); also elsewhere on the board
EXC_P: CN1.B2 (B2 EXC_P); also elsewhere on the board
FWD_12V: CN1.B4 (B4 FWD_12V), R100.1
FWD_IN: C100.1, R100.2, R101.1; also elsewhere on the board
GND: C100.2, C101.2, C102.2, C103.2, C104.2, C107.2, C108.2, C109.2, CN1.A4 (A4 GND), CN1.J2 (J2 GND), CN1.K2 (K2 GND), CN1.M3 (M3 GND), R101.2, R103.2, R105.2, R107.2, R109.2, R115.2, R117.2, R120.2, R121.2, R122.2, U20.3 (S), U21.3 (S), U22.3 (S), U23.2 (GND), U23.8 (Rs); also elsewhere on the board
IGN: CN1.L3 (L3 IGN); also elsewhere on the board
MAIN_CONT_OUT: CN1.E1 (E1 MAIN_CONT_OUT), U20.2 (D)
MOT_TEMP: CN1.J1 (J1 MOT_TEMP); also elsewhere on the board
MPROT_IN: R113.1; also elsewhere on the board
PEDAL_5V: CN1.A3 (A3 PEDAL_5V), F1.2
PRECHARGE_OUT: R121.1, U21.1 (IN); also elsewhere on the board
PRECHG_OUT_SW: CN1.E2 (E2 PRECHG_OUT_SW), U21.2 (D)
PUMP_OUT: R122.1, U22.1 (IN); also elsewhere on the board
PUMP_OUT_SW: CN1.B3 (B3 PUMP_OUT_SW), U22.2 (D)
REV_12V: CN1.C3 (C3 REV_12V), R102.1
REV_IN: C101.1, R102.2, R103.1; also elsewhere on the board
SIN_N: CN1.C1 (C1 SIN_N); also elsewhere on the board
SIN_P: CN1.C2 (C2 SIN_P); also elsewhere on the board
START_12V: CN1.D3 (D3 START_12V), R106.1
START_IN: C103.1, R106.2, R107.1; also elsewhere on the board
THR1_IN: CN1.A1 (A1 THR1_IN), R114.1, R115.1
THR2_IN: CN1.A2 (A2 THR2_IN), R116.1, R117.1
THROTTLE1: C107.1, R114.2; also elsewhere on the board
THROTTLE2: C108.1, R116.2; also elsewhere on the board
VBAT: CN1.M1 (M1 VBAT), CN1.M4 (M4 VBAT); also elsewhere on the board

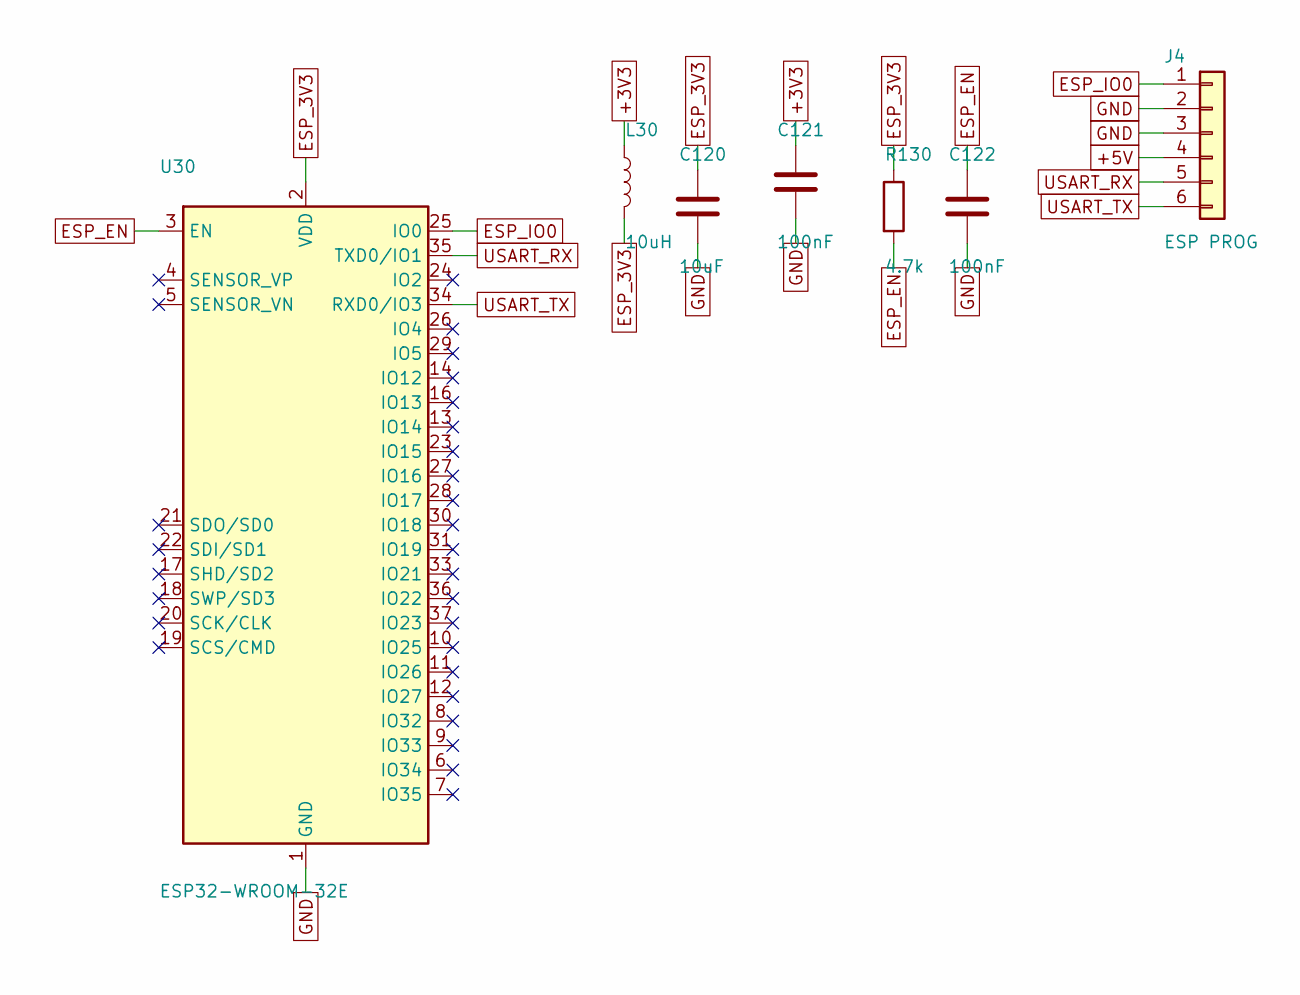
[picture p19: schematic wifi.kicad_sch, Bolt logic board - WiFi (ESP32)]

Parts:
C120: 10uF; C_1206_3216Metric
C121, C122: 100nF; C_0805_2012Metric
J4: ESP PROG; PinHeader_1x06_P2.54mm_Vertical
L30: 10uH; L_0805_2012Metric
R130: 4.7k; R_0805_2012Metric
U30: ESP32-WROOM-32E; ESP32-WROOM-32

Connections:
+3V3: C121.1, L30.1; also elsewhere on the board
+5V: J4.4; also elsewhere on the board
ESP_3V3: C120.1, L30.2, R130.1, U30.2 (VDD)
ESP_EN: C122.1, R130.2, U30.3 (EN)
ESP_IO0: J4.1, U30.25 (IO0)
GND: C120.2, C121.2, C122.2, J4.2, J4.3, U30.1 (GND), U30.15 (GND), U30.38 (GND), U30.39 (GND); also elsewhere on the board
USART_RX: J4.5, U30.35 (TXD0/IO1); also elsewhere on the board
USART_TX: J4.6, U30.34 (RXD0/IO3); also elsewhere on the board

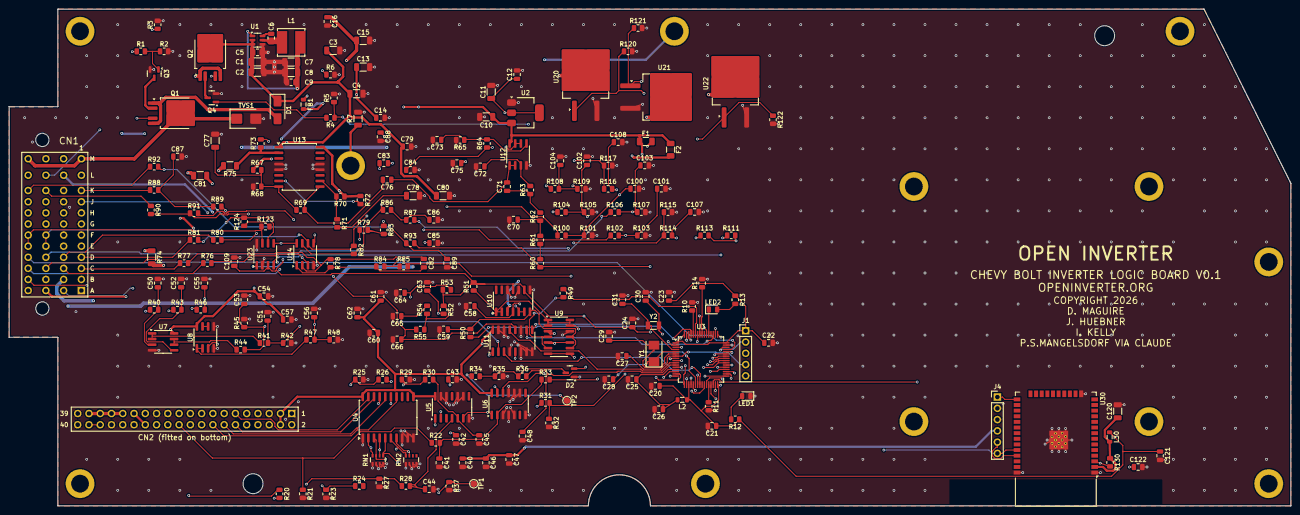
[picture p20: board bolt_logic.kicad_pcb from above]

Board: 4 copper layers, 289.0 x 112.0 mm, 243 parts (1 on the bottom side), 162 nets.
