PSMangelsdorf/Bolt_Invt/(commit log)

2026-10-10 Add Phase 2 architecture + per-pin interface map
    Maps the Bolt internal 40-pin and external 48-way connectors onto the
    STM32F103 (LDU V6 / HW_TESLA base), documents V6 reuse vs. Bolt-specific
    changes, current-sense scaling method, and the stm32-sine firmware change
    list for a new HW_BOLT variant.
    Claude-Session: https://claude.ai/code/session_01KW1M8KfVLc83FDDiK2YEWM
2026-10-10 Finalize current-sense scaling for HC5FW700-S/SP3 (2.86 mV/A)
    Sensor outputs ~0.5-4.5 V over +/-700 A, so it is attenuated (k~2/3) not
    amplified. il1gain/il2gain default ~2.37 digits/A. Note STM32 ADC ref does
    not track the 5 V rail, so rely on regulated 5 V + offset auto-cal rather
    than ratiometric cancellation.
    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
2026-10-10 Add mechanical definition draft from measurements + photo rectification
    Board outline, 16 holes, CN2 (2x20 @ 2.54) and J1 (4x12) positions in a
    component-side frame with origin at the bottom-left mounting hole. Values
    cross-checked against two perspective-corrected photos; disputed items
    flagged for caliper verification. Includes overlay image for visual check.
    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
2026-10-10 Add KiCad mechanical skeleton generated from confirmed measurements
    hardware/bolt_logic: board outline, 14 holes, CN1 (GM 48-way, A1..M4,
    M1 top-right) and CN2 (2x20 2.54 mm receptacle on the back side) at
    measured positions. tools/gen_mech.py is the single source of truth and
    asserts all 102 pad positions; KiCad DRC reports 0 violations.
    Mechanical spec updated to v0.2 with caliper-confirmed values (tab 11 mm,
    H3 61,71.7, H14 231,101, CN2 2.54 pitch). Overlay regenerated from the
    KiCad file itself.
    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
    [bolt_logic.kicad_pcb]
2026-10-10 Add schematic design spec; identify CN2 as Samtec SSW-120-01-T-D-LL
    docs/03-schematic-design.md: block-by-block design from a full read of the
    Tesla V6 schematic - HW_BOLT STM32 pin map, reuse/adapt/new/drop per block
    with values, CN1/CN2 net assignments, CN1 vehicle-pinout proposal,
    software-resolver front end, firmware change list, open questions.
    CN2 footprint: 1.02 mm drill for Samtec SSW (0.64 mm square tails).
    Architecture doc corrected: the V6 hardware is encoder-only (resolver is
    new design) and current gain is 2.25 digits/A with the V6's 2k7/4k7 divider.
    Claude-Session: https://claude.ai/code/session_01KW1M8KfVLc83FDDiK2YEWM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
    [bolt_logic.kicad_pcb]
2026-10-10 Schematic spec: apply owner decisions (CN1 reserved positions, pin 18, resolver)
    CN1: OEM-only positions (aux pump, trans fluid temp, CAN2/3, IMS, wake)
    reserved for a future OEM-compatible revision; conversion I/O on the 12 free
    positions + range-switch positions; extras moved to a new on-board aux
    header. Pin 18 assumed DC bus with a 33k/10k + clamp input; pin 20 held low.
    Motor temp pull-up 2.2k default on its own footprint. Software resolver
    confirmed.
    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
2026-10-10 Add schematic v0.1 (generated, netlist-verified) and update design spec
    hardware/bolt_logic: 7 hierarchical sheets - power, MCU, gate interface,
    analog (current sense, overcurrent, temp mux), resolver/encoder, vehicle
    I/O, WiFi - 258 parts on 169 nets. tools/sch_design.py is the design table;
    tools/gen_sch.py writes the KiCad 7 sheets with KiCad library symbols and
    verifies the kicad-cli netlist against the table pin-for-pin.
    Spec updates from capture: AP63205WU fixed-5V buck, +5V_A as a
    ferrite-filtered buck branch (more accurate than the +/-3% HV LDO), BTS443P
    for logic/gate power switches, L272D resolver exciter bridge, output-enable
    pull-downs, HW_BOLT temp-mux and break-handler firmwar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
    [analog.kicad_sch, bolt_logic.kicad_sch, gate_if.kicad_sch, mcu.kicad_sch, power.kicad_sch, resolver.kicad_sch, vehicle.kicad_sch, wifi.kicad_sch]
2026-10-11 Schematic: ESP32-WROOM-32UE (u.FL) instead of WROOM-32
    The board sits inside the aluminium inverter housing, where an on-module
    PCB antenna would not radiate, and the WROOM-32 antenna keep-out did not
    fit the layout. The UE variant is pin-identical with a u.FL connector for
    an external antenna. Netlist re-verified against the design table.
    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
    [wifi.kicad_sch]
2026-10-11 PCB layout v0.1: scripted placement and autorouting, DRC clean
    - gen_layout.py: footprints from the KiCad netlist with a pad-by-pad
    cross-check, grouped placement by function, decoupling caps placed at
    their pins, 2-pin parts rotated so each pad faces its own net.
    - gen_route.py: 4-layer stackup (In1 solid GND), pre-routed short pad
    pairs, GND fan-out before routing, FreeRouting via DSN/SES with a
    custom SES importer (KiCad 7 import needs the GUI), dangling cleanup,
    direct completion of leftover connections, GND stitching, pours with
    orphan-island vias, DRC and a routed render.
    - Net class widths are capped below the narrowest SMD pad on each net
    (FreeRouting cannot neck down i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
    [bolt_logic.kicad_pcb]
2026-10-11 Revert "Schematic: ESP32-WROOM-32UE (u.FL) instead of WROOM-32"
    This reverts commit fcac408. The WiFi stays as on the Tesla V6 board
    (PCB-antenna module); the change was not requested by the owner, and the
    housing will be handled separately.
    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
    [wifi.kicad_sch]
2026-10-11 Schematic: WiFi matches Tesla V6 IC14 exactly
    - U30 value ESP32-WROOM-32E (M113EH2800PH3Q0, PCB antenna), the V6 part;
    same land pattern as the WROOM-32 footprint.
    - 100 nF moved to the 3.3 V side of the 10 uH inductor, as V6 C11
    (10 uF stays on the module side, as C65). Netlist re-verified.
    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
    [wifi.kicad_sch]
2026-10-11 Layout: V6 WiFi module at the bottom edge, height check, rip-up completion
    - ESP32-WROOM-32E placed with its antenna end flush with the bottom board
    edge between H5 and H11 (the only edge stretch without a mounting hole
    for the 48 mm antenna keep-out); keep-out extended to all four copper
    layers and honoured by placement, routing, vias and pours.
    - Height check in gen_layout.py: owner's ~7/8 in limit from the board
    bottom (20.2 mm above the component side); every footprint checked.
    - Leftover connections: grid A* search through vias, then rip-up and
    reroute of crossed tracks; dangling vias cleaned up as well.
    - FreeRouting second pass off by default (reproducible hang).
    - DRC: 0 vi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
    [bolt_logic.kicad_pcb]
2026-10-11 Layout: spread placement over the board, 10 mm CN1/CN2 clearance
    - Placement regions now cover the whole board; MCU at the board centre.
    - Owner: no component within 10 mm of CN1 or CN2 (hand soldering);
    enforced as a placement keep-out and checked after placement.
    - Placement boxes include each part's silkscreen reference with 1.5 mm
    between boxes, so references are legible and back on the silkscreen
    (fab-layer move removed). DRC silkscreen overlaps: 17 -> 0.
    - FreeRouting passes 100 -> 40 (long tails only made runs slower; the
    completion step closes what is left).
    - DRC: 0 violations, 0 unconnected items.
    Claude-Session: http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
    [bolt_logic.kicad_pcb]
2026-10-11 Docs: record firmware decisions; correct aux header (J3) description
    The 4.13 text listed a BMS input that the schematic never had; it now
    matches the captured J3 pinout.
    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
2026-10-11 Remove the aux header (J3) and V6 leftovers: only CN1, CN2 and programming
    Owner: the only connections on the board are CN1, CN2 and what is needed
    to program it (J1 SWD, J4 ESP32).
    - Removed J3 and what only served it: aux 12 V / 5 V outputs (F3, F4),
    aux temperature pull-up and filter (R56, C67; mux 1Y1 grounded), the
    emergency-stop / motor-protection header resistors and caps (R110,
    R112, C105, C106; the 10k pull-ups stay, so the firmware reads OK).
    - CN1 G1/G2 (HVIL) only went to J3: now reserved positions.
    - PC11 (VTG_OUT) and PC5 (SPEED_OUT, never connected) now NC.
    - Re-placed and re-routed: 241 parts, DRC 0 violations, 0 unconnected.
    - Docs: 03 (pin map, 4.10, 4.12, 4.13, CN1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
    [analog.kicad_sch, bolt_logic.kicad_pcb, mcu.kicad_sch, vehicle.kicad_sch]
2026-10-11 Docs: firmware reports n/a for inputs the board doesn't have; test pads kept
    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
2026-10-18 Add CN1 OEM-vs-new pin comparison PDF
    docs/cn1_oem_vs_new.pdf: one-page table of all 48 CN1 pins with the OEM
    use (owner's pinout spreadsheet, GM Power Invert Module X1) and the use
    on this board. Generated by tools/gen_cn1_compare.py from CN1_NETS in
    sch_design.py, so it stays in step with the schematic.
    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
    [gen_cn1_compare.py]
2026-10-29 Lay out the 5 V buck as a fixed, hand-designed block
    U1 (AP63205) and its parts are placed at fixed offsets from U1 (tools/buck_block.py),
    following the datasheet layout guidance: input caps stacked under the VIN/GND pins,
    bootstrap cap beside BST/SW, a short wide SW strip to L1, output caps under L1 with
    their ground tied to the input-cap ground, FB sensed on B.Cu under the In1 plane.
    gen_layout.py places the block before the placer and moves its silkscreen labels to
    its outside edge. gen_route.py draws the block copper as locked tracks/vias before
    pre-routing; prestub treats existing copper as obstacles and skips block-internal
    pairs, and the GND fan-out leaves the block's pads alone. No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
    [buck_block.py, gen_layout.py]
2026-10-29 Route the board with the buck block; keep the block locked
    Full re-route with the fixed 5 V buck block: 0 unconnected, 0 clearance/short/keep-out
    violations, only the expected environmental DRC warnings. The block's copper now stays
    locked in the committed board (and the completion rip-up skips locked tracks), so it
    can't be moved by a hand edit or a later pass. Adds docs/buck_block.png
    (tools/render_block.py) and updates the results in docs/04-layout.md.
    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
    [bolt_logic.kicad_pcb]
2026-10-29 Use 2 oz outer copper; keep 6.8 uH for the buck inductor
    Owner decisions: order the board with 2 oz finished copper on the outer layers (the
    AP63205 datasheet suggests it for heat), inner layers 1 oz; keep L1 at 6.8 uH.
    gen_mech.py now writes this stackup into the board file (the v7 bindings don't expose
    the stackup; pcbnew keeps it through later load/save). Applied to the routed board
    without re-routing. docs/04-layout.md records the 2 oz fab limits: the board has every
    copper gap >= 0.2 mm, 0.2 mm minimum track and >= 0.34 mm PTH annular ring, which meets
    JLCPCB's 4-layer 2 oz rules but not a fab that needs 10/10 mil at 2 oz.
    Claude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
    [bolt_logic.kicad_pcb]
2026-10-29 Fix BTS443P input drive with 2N7002 pull-downs (Q3, Q4); re-route
    The BTS443P has no GND pin and switches on when IN is pulled to ground (input switch
    sinks 0.7-1.2 mA; < 50 uA keeps it off). The schematic drove IN like a logic input:
    Q1's IN went to GND through 6.8k (always on, regardless of ignition) and Q2's IN to
    PA15 through 1k (gate power could never be switched off).
    Owner-approved fix: a 2N7002 from each IN to GND. Q3's gate comes from the existing IGN
    divider (10k/6.8k); Q4's from PA15 through R4, with the existing R5 (10k) holding it
    off while PA15 is still JTDI with its internal pull-up at reset. Firmware polarity and
    board detection are unchanged.
    Re-placed and re-routed: 0 unc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
    [bolt_logic.kicad_pcb, power.kicad_sch]
2026-10-29 Add the v0.1 prototype fabrication package (JLCPCB)
    tools/gen_fab.py writes fab/: Gerbers + Excellon drill (zip), JLCPCB assembly BOM and
    placement file, a full BOM, and fab notes (order settings incl. 2 oz outer copper,
    hand-fit list, open items). tools/jlc_parts.py holds the proposed LCSC part for every
    BOM line with where it was checked (LCSC/JLCPCB listing, or the Tesla V6 JLC BOM);
    these are proposals for owner approval.
    Checked: the Gerbers and drill files load in gerbonara, placement points land on the
    parts in the rendered Gerbers, DRC passes at 0.20 mm.
    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
    [bolt_logic_v0.1_bom_full.csv, bolt_logic_v0.1_bom_jlc.csv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]
2026-10-29 Silkscreen: owner's board text, CN1/CN2 outlines and pin labels
    Adds the owner's text block (OPEN INVERTER / CHEVY BOLT INVERTER LOGIC BOARD V0.1 /
    OPENINVERTER.ORG / COPYRIGHT 2026 / authors) in the empty area right of the MCU,
    reserved from placement (TEXT_AREA). CN1 and CN2 footprints had no silkscreen: CN1 now
    has an outline, row letters A-M, pin 1 and its reference; CN2 an outline and pins
    1/2/39/40 on both sides (soldered from the top) and its reference on the bottom.
    Silk only, no copper change; DRC unchanged; fab files regenerated.
    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
    [bolt_logic.kicad_pcb]
2026-10-29 Use JLCPCB-stocked parts: BTS6143D, 74HCT10, TCA0372 (schematic)
    Owner-approved part changes so JLCPCB can assemble the board:
    - Q1/Q2 BTS443P -> BTS6143D: same PG-TO252-5-11 pinout and IN-to-GND input, so the
    symbol, footprint and Q3/Q4 drive are unchanged (BOM only).
    - U6 CD74HCT30 -> 74HCT10: PWM_INHIBIT = NAND(GATE_OK_5V, GATE_FLT_F, OCUR_OK), the
    same logic since U5 already ANDs HEALTH1-4.
    - U13 L272D -> onsemi TCA0372DW (SOIC-16W), new custom symbol; exciter values unchanged.
    - BOM: 3.3 nF C0G -> Murata GRM2165C1H332JA01D (previous choice out of stock);
    74HCT4052 -> TI CD74HCT4052M96 C469908 (confirmed listing); BTS133TC kept (owner).
    The routed board and regenerated fab files f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
    [gate_if.kicad_sch, power.kicad_sch, resolver.kicad_sch]
2026-10-29 Route the board with the stocked parts; regenerate fab files
    Full re-place and re-route with U6 = 74HCT10 and U13 = TCA0372DW (SOIC-16W):
    0 unconnected, DRC clean (also at 0.20 mm clearance), buck block intact and locked,
    owner's silkscreen text and CN1/CN2 marks in place. fab/ regenerated: JLC BOM 61
    lines / 220 placements; only CN1, CN2, J1, J4 are hand-fit (plus U20-U22 if JLCPCB
    can't place BTS133TC C2681318). Checked in an independent Gerber reader: all layers
    and drill files load and placement points land on the changed parts.
    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
    [bolt_logic.kicad_pcb, bolt_logic_v0.1_bom_full.csv, bolt_logic_v0.1_bom_jlc.csv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]
2026-10-30 BOM: Littelfuse SMBJ26CA for TVS1, SN74ACT10 for U6 (stock)
    JLCPCB is out of stock on the Bourns SMBJ26CA (C3719606) and the 74HCT10D (C547236).
    - TVS1: Littelfuse SMBJ26CA C83332, same spec and SMB package.
    - U6: TI SN74ACT10DR C2861739, same '10 pinout and SOIC-14; ACT has TTL-level inputs
    (VIH 2.0 V) like HCT, so the 3.3 V OCUR_OK line still reads high at 5 V.
    No copper change: the routed board only gets U6's value updated; Gerber and drill
    artwork is identical to the merged version apart from the generation dates. Schematic,
    schematic PDF, fab BOM and docs regenerated.
    Claude-Session: https://claude.ai/code/session_01KW1M8KfVLc83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
    [bolt_logic.kicad_pcb, bolt_logic_v0.1_bom_full.csv, bolt_logic_v0.1_bom_jlc.csv, gate_if.kicad_sch]
2026-11-06 Move the v0.1 board into V0.1/
    Moves docs/, fab/ and hardware/ into the owner's V0.1/ folder with git mv (history is
    kept; nothing is deleted). The generator scripts use paths relative to their own
    location, so they still run from V0.1/hardware/bolt_logic and write to V0.1/fab and
    V0.1/docs. LICENSE and README.md stay at the repository root.
    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
    [analog.kicad_sch, bolt_logic.kicad_pcb, bolt_logic.kicad_sch, bolt_logic_v0.1_bom_full.csv, bolt_logic_v0.1_bom_jlc.csv, gate_if.kicad_sch, mcu.kicad_sch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]
